mknudsen404-QA/4KeyPOC/CODEX_MICRO_CONSOLE_DESIGN.md

# Switchboard Design Decisions

Last updated: 2026-09-06

## Product Name

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

## Current Working Baseline

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

What is already working:

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

Current board port used during bring-up:

```text
/dev/cu.usbmodem2301
```

## Current Bridge Boundary

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

## Status Auto-Detection Plan

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

**Superseded first attempt (log-tail pattern matching).** The original plan was to tee session output via `script -q` and pattern-match the ANSI-stripped tail. Implemented and tested live, but a real captured log showed the flaw: Codex's TUI is a full-screen, cursor-positioned alternate-screen interface (`\e[row;colH` redraws, box-drawing glyphs), not linear scrolling text — naive ANSI-stripping cannot turn that into reliably matchable text; a correct version would need a real terminal emulator (`pyte`) to reconstruct the rendered screen first. The tee/log infrastructure (`host/logs/slot-N.log`, `poll_slot_logs`, `classify_activity`) is still in place as a secondary/best-effort signal, but is not the primary mechanism.

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

Known limitations: hooks only take effect for sessions started *after* `install-hooks` runs (already-running sessions, e.g. one launched before this was wired in, won't call the new hooks until restarted). The event→status mapping is a reasonable first guess, not yet calibrated against a full real session — `PreToolUse` only fires for `AskUserQuestion` specifically (not all tool calls), and Codex has no dedicated error/`blocked` hook signal (OpenMicro notes the same gap: "⚠️ Notification-text matching" for Claude, "— No error hook signal" for Codex), so `blocked` still depends on the secondary log-based classifier for now.

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

## Verified Hardware Facts

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

Rotary encoder guidance now that real pins are known:

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

## Project And Reference Locations

Primary live firmware project:

```text
/Users/matthewknudsen/Documents/Codex-Micro-Matt/Codex_Micro_Display
```

Design decisions:

```text
/Users/matthewknudsen/Documents/Codex-Micro-Matt/Codex_Micro_Display/CODEX_MICRO_CONSOLE_DESIGN.md
```

Session deliverable copies:

```text
/Users/matthewknudsen/Documents/Codex/2026-09-05/referenced-chatgpt-conversation-this-is-an/outputs/CODEX_MICRO_CONSOLE_DESIGN.md
/Users/matthewknudsen/Documents/Codex/2026-09-05/referenced-chatgpt-conversation-this-is-an/outputs/README_CODEX_MICRO.md
```

Stable copied PDF references:

```text
/Users/matthewknudsen/Documents/Codex-Micro-Matt/Codex_Micro_Display/docs/reference/5. LVGL Development Tutorial.pdf
/Users/matthewknudsen/Documents/Codex-Micro-Matt/Codex_Micro_Display/docs/reference/6. ESP32-S3 Development Board Diagram_V1.1.pdf
```

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

Original extracted Hiwonder source-code examples:

```text
/Users/matthewknudsen/Documents/Codex-Micro-Matt/Source Code
```

Key source-code examples:

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

Original Arduino examples:

```text
/Users/matthewknudsen/Documents/Codex-Micro-Matt/Arduino Program
```

Key Arduino examples:

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

Original archives:

```text
/Users/matthewknudsen/Documents/Codex-Micro-Matt/Arduino Program.rar
/Users/matthewknudsen/Documents/Codex-Micro-Matt/Source Code.rar
```

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

Claude review notes:

```text
/Users/matthewknudsen/Documents/Codex-Micro-Matt/Codex_Micro_Display/CLAUDE_REVIEW_BRIEF.md
/Users/matthewknudsen/Documents/Codex-Micro-Matt/Codex_Micro_Display/CLAUDE_FEEDBACK.md
```

Host bridge:

```text
/Users/matthewknudsen/Documents/Codex-Micro-Matt/Codex_Micro_Display/host/switchboard_bridge.py
/Users/matthewknudsen/Documents/Codex-Micro-Matt/Codex_Micro_Display/host/install_bridge_launch_agent.py
/Users/matthewknudsen/Documents/Codex-Micro-Matt/Codex_Micro_Display/host/README_BRIDGE.md
/Users/matthewknudsen/Documents/Codex-Micro-Matt/Codex_Micro_Display/host/EXTERNAL_KEY_SPIKE.md
/Users/matthewknudsen/Documents/Codex-Micro-Matt/Codex_Micro_Display/host/agents.example.json
```

## Core Concept

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

The screen answers three questions at a glance:

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

The controls send deliberate command intents:

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

## Layer Model

The first real layer set should be:

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

The current firmware still shows the older placeholder layers:

```text
CODEX
QA
SYSTEM
```

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

## Rotary Dial

The rotary dial should adjust the selected agent's reasoning effort.

Initial reasoning-effort scale:

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

## Visual Identity

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

Initial 8-bit identity sprites:

```text
CODEX
..####..
.#....#.
.#.##.#.
.#....#.
.#.##.#.
.#....#.
..####..
...##...

CLAUDE
..####..
.#....#.
.#.##.#.
.#....#.
.#.####.
.#....#.
..####..
..#..#..
```

Initial effort sprites:

```text
LOW
...##...
..#..#..
..#..#..
...##...
........
....#...
........
........

MEDIUM
...##...
..#..#..
..#..#..
...##...
........
...###..
.....#..
........

HIGH
...##...
..#..#..
..#..#..
...##...
........
..#####.
.....#..
..###...

XHIGH
...##...
..#..#..
..#..#..
...##...
..#..#..
...##...
..####..
.#....#.

MAX
..#..#..
...##...
.######.
#..##..#
...##...
..####..
.#.##.#.
#..##..#
```

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

Possible effort-color mapping:

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

Claude/Codex distinction:

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

## Illuminated Keys And Status

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

Target agent bank for v1:

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

Target command bank for v1:

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

Status should be key-light-first for glanceability and text-confirmed on screen:

```text
WORKING      + orange pulse
NEEDS INPUT  + yellow fast flash
BLOCKED      + red solid
DONE         + green or blue solid
```

Proposed lit-key meanings:

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

Status light behavior:

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

Hardware direction:

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

## Microphone Key

There should be a dedicated microphone key.

Decision: KEY4 becomes the microphone key on the Agents layer.

Behavior:

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

## Agent Navigation

The console should support four running CLI agents at once for v1.

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

The selected agent card should show:

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

Agent slot behavior:

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

Future rotary behavior:

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

## Agent Status Colors

The screen, illuminated keys, and future WS2812 LEDs should use the same status language.

| Status | Color | Meaning |
| --- | --- | --- |
| Empty | Off | No agent assigned to this slot |
| Idle | Dim white | Agent is available or task is quiet |
| Thinking | Purple pulse | Agent is reasoning or planning |
| Working | Orange pulse | Agent is actively doing work |
| Editing | Blue pulse | Agent is changing files |
| Testing | Amber or orange pulse | Agent is running checks |
| Waiting | Cyan slow pulse | Agent is waiting on tools, build, or external state |
| Needs Input | Yellow fast flash | User decision or clarification required |
| Blocked | Red solid | Agent cannot proceed without intervention |
| Done | Green or blue solid | Task completed or command succeeded |

Decision: illuminated keys are status indicators first. The screen should always keep the text status visible so color is never the only source of meaning.

Open color choice: Matthew likes orange for "working." Claude flagged that orange versus amber and red flash versus red solid may be hard to distinguish on real key hardware. Tentative revision: use yellow fast flash for Needs Input, red solid for Blocked, orange pulse for Working, and decide whether Testing deserves amber only after seeing real LEDs under real keycaps. Done can be steady green or steady blue; choose after seeing which color reads best on the actual key hardware.

## Command Keys

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

Bring-up mapping while only onboard KEY1-KEY4 are connected:

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

## Custom Slash Command

KEY4 on the Commands layer should trigger a configurable slash command.

Initial placeholder:

```text
/review
```

Better future behavior:

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

## Host Bridge

The ESP32-S3 firmware should stay focused on UI, inputs, status display, and audio capture.

Decision: a host-side bridge on the Mac should translate device events into Codex actions.

Suggested event names:

```text
agent.select
agent.focus
agent.reasoning.preview
agent.reasoning.apply
voice.toggle
voice.hold.start
voice.hold.stop
plan.approve
review.request
slash.run
system.status
```

Likely transport options:

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

Example event:

```json
{"event":"agent.reasoning.apply","agent":"current","effort":"high"}
```

Agent selection event:

```json
{"event":"agent.select","slot":3}
```

Agent focus event:

```json
{"event":"agent.focus","slot":3}
```

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

## Screen Layout Direction

The next screen should move from static layer text to a compact agent console.

Proposed Agents layer:

```text
CODEX MICRO CONSOLE

AGENT  3/4        HIGH

review-api-fix
WORKING
main/APP/lv_mainstart.c

KEY 3: ORANGE PULSE
ROTARY EFFORT
C3 APPLY  C4 HOLD MIC
```

Proposed Commands layer:

```text
COMMANDS

Approve Plan
Request Review
Run /review

C1 HOLD APPROVE
C2 REVIEW
C3 HOLD RUN
C4 HOLD MIC
C5 /SLASH
C6 BACK
```

## Near-Term Firmware Plan

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

## Hardware Direction Change: Bare Devkit + Detached Display

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

## Proof-of-Concept Hardware — Locked

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

Default 6-command mapping (customizable — see below):

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

## V2 Direction: Custom Single PCB

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

## Open Questions

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
