mknudsen404-QA/4KeyPOC/docs/design/hardening-pass-plan.md

# Hardening pass — second unit prep

Written 2026-10-03. Handoff document for an implementing agent. Scope set
by the owner in planning conversation: macOS-only install polish (not the
full cross-platform `auto-install-plan.md`), Codex voice fixed now with
Antigravity scoped as a research spike, log rotation closed for real, the
settings UI made discoverable without a terminal, and the 4key board
pushed to fab-ready.

This supersedes nothing — `auto-install-plan.md`, `family-capability-matrix.md`,
and `hardware/kicad/README.md` remain the source of truth for the larger
plans this pulls from. This document is the near-term slice actually being
built now, ahead of shipping a second unit.

## Workstream A — Voice: Codex now, Antigravity scoped

**Status (2026-10-03): A1 done, A2 done and went further than scoped —
confirmed live, not just spiked.** See `docs/design/family-capability-matrix.md`
for the full writeup. Summary:

- A1: Codex voice confirmed working end-to-end (macOS Dictation bound to
  F13, held via the board's PTT key, transcribed into a real Codex
  session). Two real bugs fixed along the way: `doctor.py` imported
  `AXIsProcessTrusted` from the wrong module (always reported
  Accessibility as ungranted even when it wasn't), and the Dictation
  availability check used a macOS preference key that no longer exists on
  macOS 26.
- A2: went from "research spike" to "shipped" in the same session —
  Antigravity CLI (`agy`, via `brew install --cask antigravity-cli`) now
  has a real `AntigravityProfile`, registered in the family registry,
  with effort control (clamped to what its default Gemini model actually
  supports) and voice PTT confirmed live the same way as Codex. Hooks are
  explicitly NOT wired (a real, scoped gap — Antigravity's hook mechanism
  is structurally different: project-local config file, synchronous
  execution that blocks the agent loop, a required JSON response contract
  per event, no session-start/session-end signal at all) — tracked in
  `families/antigravity.py`'s docstring for whoever picks it up next.
- A structural bug in the voice-PTT plumbing itself was found and fixed
  while verifying both of the above: the single shared `key_injector`
  posts events to one specific process (`CGEventPostToPid`) — correct for
  `claude_native` typing into Claude's own terminal, but silently
  incapable of triggering a system-wide OS shortcut like a configured
  Dictation hotkey (`CGEventPostToPid` bypasses global-hotkey dispatch
  entirely). `VoiceContext` now carries a second injector,
  `global_key_injector`, posting via `CGEventPost(kCGHIDEventTap, ...)`.
  This is what actually made the Codex and Antigravity verifications
  above possible, not just the chord/availability fixes.

**A1. Make Codex voice actually work (same-session fix, not a design problem).**
Per `family-capability-matrix.md`'s Phase 4 update, the `hotkey` provider is
wired and correct but has nothing to drive — no dictation app is installed
on this Mac, and built-in macOS Dictation has never been enabled
(`defaults read -g AppleDictationAutoEnable` returns "does not exist").

1. Enable built-in macOS Dictation (System Settings → Keyboard → Dictation)
   as the zero-install path — no new app, no license. Confirm its default
   shortcut doesn't collide with anything Switchboard already uses, and
   point `hotkey`'s `chord` at whatever that shortcut is (`switchboard/voice/hotkey.py`'s
   docstring names the exact check to redo).
2. Re-run Phase 4.4's validation: a Codex slot with `provider: hotkey`
   actually recording and landing transcribed text in the Codex prompt on
   a hold.
3. Update `doctor` / `/api/voice-providers` output and
   `family-capability-matrix.md` with the confirmed-live result — these
   already report availability honestly, they just need the underlying
   fact to flip from false to true.
4. If built-in Dictation proves unreliable (accuracy, latency, or requires
   per-hold network round-trip to Apple's servers in a way that feels
   bad), fall back to evaluating one real third-party app (Superwhisper is
   the most relevant price/quality point) as a second supported option —
   `hotkey` already doesn't care which app owns the shortcut.

**A2. Antigravity family-profile spike (research, not yet implementation).**
No `FamilyProfile` exists for Antigravity today — `grep` confirms zero
references anywhere in `host/switchboard/`. Follow the exact method
`family-capability-matrix.md` used for Gemini/Kimi: read Antigravity's own
docs/`--help`, install it for real if a CLI/terminal surface exists, and
fill in the same matrix row before writing code:

- Does it expose a CLI/terminal mode at all, or is it IDE-only (it's a
  VS Code-family agentic IDE — confirm whether any part of its agent loop
  is scriptable from a terminal session Switchboard could launch/observe).
- Lifecycle hooks: do any exist, what events, what config file/shape,
  does `SWITCHBOARD_SLOT` env passthrough survive.
- Effort/reasoning control: flag, config file, or none.
- Native voice/dictation surface, if any.
- Session-end signal.

Output: a new row in `family-capability-matrix.md`, same rigor as
Gemini/Kimi (mark anything unverified as unverified — don't guess).
**Do not write an `AntigravityProfile` until that spike has real answers**;
if it turns out IDE-only with no terminal/hook surface, the honest
`capabilities()` result may just be `tier="launch_only"` forever, same as
`GenericProfile` — which is a legitimate outcome, not a gap to fix.

## Workstream B — macOS install hardening (no MSC drive, no Windows)

**Status (2026-10-03): 1 done, 2 smoke-tested live (not a full matrix), 3
confirmed already adequate, 4 confirmed already structurally safe.**

- **1 — done.** `doctor` already exits non-zero only on a genuine `[fail]`
  (board-unplugged states were already `[warn]`, confirmed by reading
  every check in `doctor.py` — no separate `--strict` flag was needed).
  The actual gap was that `setup.sh` never called it at all; it now runs
  `doctor` as its final step and `die`s with a clear message if anything
  comes back `[fail]`. Found and fixed a real race surfaced by this: right
  after `install_bridge_launch_agent.py` restarts the bridge, the hook
  server needs a moment to bind its socket — `doctor` run immediately
  after could catch it mid-startup and print a spurious `[warn] hook
  port: nothing listening` on an install that was actually fine. Fixed
  with a bounded poll (up to 5s, moves on the instant the port answers)
  rather than a blind sleep.
- **2 — smoke-tested live on the real dev machine, twice in a row**
  (already fully set up: venv/agents.json/hooks/LaunchAgent all present).
  Both runs correctly skipped what existed, reported hooks "unchanged,"
  and the new `doctor` gate passed clean on the second run (after the
  race fix). This confirms the already-set-up case is genuinely
  idempotent; it is **not** the synthetic half-state test matrix the plan
  originally asked for (hooks-but-no-LaunchAgent, LaunchAgent-but-no-venv,
  etc.) — that would need a sandboxed `$HOME` harness and is still real,
  open follow-up work, not attempted this pass.
- **3 — already adequate, no change needed.** `doctor`'s `LaunchAgent`
  check already covers load state live (confirmed: it shells out to
  `launchctl print` and reports `[warn]` if not loaded) — `switchboard
  doctor` already is the "is it healthy right now" command the plan asked
  for; nothing to add.
- **4 — already structurally safe, documented rather than changed.**
  `install_bridge_launch_agent.py` always writes to the same fixed path
  (`~/Library/LaunchAgents/com.switchboard.bridge.plist`) under the same
  fixed label (`com.switchboard.bridge`), computed fresh from `__file__`
  at run time — launchd only ever tracks one job per label, so re-running
  `setup.sh` from a different checkout path correctly overwrites and
  reloads the single existing entry rather than creating a second one.
  Confirmed no legacy/differently-labeled plist exists on this machine
  today. The one scenario this doesn't cover — a bridge started by hand
  outside the LaunchAgent, left running, fighting over the serial port —
  is already *detected* by `doctor`'s serial-port check ("another bridge
  is running... busy"); actually *preventing* that (a pidfile/lock before
  `listen` binds the port) would be new mechanism for a rare, already-visible
  case, and wasn't built this pass.

Goal: `setup.sh` / the LaunchAgent survive re-runs, upgrades, and a
half-broken prior state without the user ever opening a terminal twice.
Reuses ideas from `auto-install-plan.md` Phase 2 (steps-as-objects,
`doctor --strict` as the consistency gate) without its cross-platform
`platform/` adapter layer, `uv` bootstrap, or MSC volume.

1. **`doctor --strict`**: add the exit-nonzero-on-any-fail variant called
   out in the original plan (today `doctor` reports but `setup.sh` doesn't
   gate on it). `setup.sh` runs it as the last step and tells the user
   exactly what failed instead of silently finishing "successfully" with a
   broken bridge.
2. **Idempotent re-run audit**: `setup.sh` already claims idempotency —
   verify it against a simulated half-state (venv exists but hooks don't;
   `agents.json` exists but LaunchAgent doesn't; old LaunchAgent present
   from a previous checkout path) rather than only the clean-machine case.
   Add this as a real test matrix, not just a doc claim.
3. **Self-healing LaunchAgent**: `KeepAlive: True` already restarts the
   bridge on crash. Add a `doctor`-driven health check path: a documented
   way to ask "is the installed bridge actually healthy right now" without
   re-running the whole installer (`switchboard doctor` already mostly
   does this — make sure it covers LaunchAgent load state, which it's
   listed as covering in `README_BRIDGE.md` but should be double-checked
   live).
4. **Migration safety**: if a second unit gets built on a Mac that already
   has an older checkout/LaunchAgent from this project's own dev history,
   re-running `setup.sh` must detect and cleanly replace it, never run two
   bridges fighting over the same serial port. This is explicitly called
   out as a risk in `auto-install-plan.md` 5.3 — worth covering even in
   the macOS-only slice since it's cheap and real (you, specifically, will
   hit this on your own machines).
5. **What's explicitly out of scope for this pass**: the `SWITCHBD` USB
   MSC drive, the signed/notarized installer, Windows support entirely.
   Those stay in `auto-install-plan.md` for when a GUI-only user is
   actually in the loop (e.g. shipping to someone who isn't you).

## Workstream C — Close the unbounded-log gap for real

**Status (2026-10-03): done, exactly as scoped, verified live.** Both
bugs fixed: `bridge.err.log` now rotates (it never did before), and
rotation is continuous, not just at process start — `RotatingStream`
(`host/switchboard/trace.py`) reassigns `sys.stdout`/`sys.stderr` to
instances backed by `logging.handlers.RotatingFileHandler` (same
mechanism `TraceWriter` already used for `trace.jsonl`), active only
under the LaunchAgent (`SWITCHBOARD_MANAGED_LOGS=1`, set in the plist) so
an interactive terminal run is unaffected. `install_bridge_launch_agent.py`
keeps launchd's own `StandardOutPath`/`StandardErrorPath` as a
crash-visibility fallback for the brief window before reassignment runs.
Verified live: regenerated the plist, restarted the LaunchAgent, confirmed
fresh timestamped lines land in `bridge.out.log` through the new path and
`doctor` stays green. Audited for other unbounded writes
(`grep -rn "open(.*['\"]a['\"]"`) — none found; `agent_registry.json` is
rewritten whole, not appended, so it was never a log in the first place.

Two concrete bugs found, not a redesign:

1. **`bridge.err.log` is never rotated at all.** `_rotate_bridge_out_log`
   (`host/switchboard/cli.py`) only ever touches `bridge.out.log`. Apply
   the identical rename-on-oversize treatment to `bridge.err.log` at the
   same call site.
2. **Rotation only happens at process start, not during a long-running
   session.** `_rotate_bridge_out_log()` is called once in `listen()`
   before the reconnect loop. The LaunchAgent (`KeepAlive: True`, `RunAtLoad:
   True`) is designed to stay up for weeks, so a healthy bridge that never
   crashes never rotates again after its first start. Worse: per the
   function's own docstring, renaming the path mid-run doesn't actually
   stop the *current* process's writes from landing in the renamed
   (still-open) inode — the rename only helps the *next* restart get a
   fresh file. True continuous bounding needs the bridge to stop relying
   on launchd's raw `StandardOutPath`/`StandardErrorPath` fd inheritance
   and instead manage its own output the way `trace.py` already manages
   `trace.jsonl` (a real `RotatingFileHandler`-backed stream that Python
   itself reopens on rotation). Concretely: redirect `sys.stdout`/`sys.stderr`
   in `listen()` to a small wrapper around `RotatingFileHandler` when
   running under the LaunchAgent (detect via an env var the plist sets),
   leaving interactive terminal runs untouched.
3. Add a regression test: a fake writer that pushes bytes past `max_bytes`
   across multiple simulated "ticks" (not just at start) and asserts the
   file never exceeds a bound, mirroring the existing
   `test_status_table_header_is_current`-style guard-rail tests.
4. Audit anything else that writes unboundedly: `agent_registry.json` is
   state, not a log (rewritten whole, not appended — fine). Hook curl
   calls (`curl -s --max-time 1 ... || true`) don't write locally. Confirm
   nothing else was missed with a quick `grep -rn "open(.*['\"]a['\"]" host/`.

## Workstream D — Make the settings UI findable without a terminal

**Status (2026-10-03): done, built differently than originally proposed
below — the owner asked for "an icon like every other application,
double-click it and it opens settings" rather than a persistent menu bar
status item, which is both simpler and needed no new dependency.**

What shipped: `switchboard/osa_app.py`, a small shared helper that builds
a plain double-clickable macOS `.app` via `osacompile` (built into macOS)
wrapping one shell command, with `try`/`on error` AppleScript so a
failure shows as a native notification (using the wrapped command's own
stderr as the message) instead of silently doing nothing. Two apps built
on it, both regenerated fresh by `setup.sh` on every run (paths are
baked in per-machine, same reasoning as the LaunchAgent plist):

- **`install_settings_app.py`** → `~/Applications/Switchboard Settings.app`
  — wraps the existing `switchboard settings` CLI command verbatim, so a
  double-click either opens the settings page or shows "No bridge is
  listening..." as a notification if it isn't running.
- **`install_update_app.py`** → `~/Applications/Switchboard Update.app`
  — `git pull --ff-only && setup.sh`, with a success notification
  ("Switchboard is up to date.") or the git/setup failure surfaced the
  same way. This was the owner's own follow-up ask mid-session ("we
  probably should have something very nice and simple for pushing
  updates") — intentionally the simplest thing that could work for the
  macOS-only, dev-checkout-based scope this whole pass is already
  working within (`--ff-only` refuses rather than guesses if the local
  checkout ever has commits of its own), not the full signed-release
  `switchboard upgrade` from `auto-install-plan.md`.

Both verified live end-to-end: double-clicked each, confirmed the
settings page opened and the update notification appeared; separately
verified the Settings app's failure path by stopping the bridge first
(see the incident note below).

Covered by `host/tests/test_osa_app.py` (the AppleScript-escaping logic
specifically — the one part worth real test coverage; the two top-level
install scripts stay untested like `install_bridge_launch_agent.py`
already was, consistent with this repo's existing convention for that
category of script).

**Incident note**: stopping the bridge to test the Settings app's
failure path (on the same slot actively being used for this session)
caused a real `Stop` hook to be silently dropped — the fire-and-forget
curl hook has no retry by design, so a slot's status can get stuck
showing busy if the bridge happens to be down for the instant a hook
fires. Not a new bug, just newly demonstrated; self-corrects on the next
status-changing event once the bridge is back. No change made — logged
here in case it's worth a retry/staleness fallback later.

**Not built, and deliberately not**: the menu bar `rumps` approach
originally proposed below, a full native app bundle project, a Dock
icon, or any code signing/notarization — none of it was needed once the
actual ask turned out to be simpler than the plan assumed.

<details>
<summary>Original proposal (superseded by the above)</summary>

Proposed fix: a small macOS **menu bar helper** (status item, not a Dock
app), the minimum-infra way to give this product a persistent "it's alive
and here's where to configure it" surface:

- New tiny companion script (`host/switchboard_menubar.py`), built on
  `rumps` (single new dependency, pure-Python, no Xcode project needed).
  Runs as its own LaunchAgent, separate from the bridge process — `rumps`
  needs the main thread for its `NSApplication` run loop, which doesn't
  mix cleanly with the bridge's own threads, and keeping it a separate
  process means a menu bar crash can never take the bridge down (and vice
  versa).
- Menu: current connection state (board plugged in? bridge running?
  pulled from the same loopback endpoint `doctor`/the settings page
  already use), "Open Settings", "Run Doctor" (shows `doctor`'s output in
  a simple window or notification), "Download Diagnostics" (same
  `support-bundle` the settings page already exposes), "View Logs".
- Icon reflects the single most useful glance-state: grey = bridge not
  running, color = running (optionally reusing the same status-color
  language already defined for the keys/screen, for visual consistency
  with the rest of the product).
- Installed by the same `setup.sh` pass as the bridge LaunchAgent — one
  install, two small long-running helpers, consistent with how the bridge
  itself is already installed.
- Explicitly not building: a full native app bundle, a Dock icon, or
  anything requiring code signing/notarization for this internal/gift-unit
  stage. `rumps` apps run fine unsigned for local/per-user use.

</details>

## Workstream E — 4key board: close the fab-blocking punch list

**Status (2026-10-03): the two biggest open questions resolved (safely),
three real generator bugs found and fixed, one real gap surfaced that still
needs a human decision.** Full detail lives in `hardware/kicad/README.md`'s
"ERC/DRC status" and "Symbols and footprints" sections now — this is the
summary.

Verified against primary-source datasheets (not search-engine summaries,
which were caught being wrong twice along the way — once claiming XL9555's
SDA/SCL were swapped, once claiming two ESP32-S3-WROOM-1 GND/thermal pins
were GPIOs): all 41 ESP32-S3-WROOM-1 pins and all 24 XL9555 pins in
`boarddef.py` match their real datasheets exactly. An independent Opus
review of the whole design, run in parallel, confirmed this and caught
three things a pinout check alone couldn't:

1. `gen_pcb.py` ignored `p.nc` entirely (`gen_sch.py` didn't) — real
   schematic/PCB drift, fixed.
2. No bulk cap at U1's own +3V3 pin — added (C9), routed, DRC-clean on all
   three tiers.
3. No USB ESD protection — added (a USBLC6-2SC6 TVS array, D_ESD), pinout
   confirmed against the actual symbol KiCad ships, left unrouted like the
   rest of the differential pair.

All three tiers regenerated and re-verified: 0 DRC violations, 0 ERC
violations (up from 34/38/42 unconnected items to 39/43/47 — expected,
from D_ESD's new unrouted nets, nothing previously-routed changed).

One real gap surfaced, not yet closed: the LED footprint/part pairing
(`boarddef.py` uses the plain SK6812MINI, not the "-E" variant) is
internally consistent, but the current-budget math upstream of this
workstream was computed against the wrong datasheet (the "-E" one) — the
plain part's own datasheet doesn't list a per-channel current figure the
same way. Needs the exact SKU locked down before ordering, not a code fix.
Also confirmed: no enclosure/case file exists in this repo at all (only a
version-badge tile), so the mounting-hole-vs-case punch list item is
currently impossible to do, not just undone. And the trademark gut-check
elevated "THE SWITCH" specifically as the one to worry about (same product
class as Nintendo's Switch mark) — treat all three tier nicknames as
internal codenames until a real search is done.

`hardware/kicad/4key/README.md`'s "Before you send these to a fab" list is
already the right checklist — this workstream is executing it, in the
order that front-loads the highest-cost-to-get-wrong items first (matches
the README's own ordering):

1. **Physical test-fit** — print the key field 1:1, test-fit a real Kailh
   hot-swap socket, a real Gateron MX switch (already have 36 on hand),
   and a real SK6812MINI. Confirms socket pads, 3.05 mm pin holes, 4 mm
   centre hole, ±5.08 mm plate holes, and the LED's 5.0 mm offset/side —
   called out as the one check that cannot be skipped.
2. **XL9555 footprint verification** — the schematic currently stands in
   `Interface_Expansion:PCF8575DBR` for the XL9555. Either confirm the
   TSSOP-24 pinout truly matches against the XL9555 datasheet, or simplify
   by just buying PCF8575s for v1 (functionally identical to the firmware,
   per the README) and dropping the open question entirely.
3. **ESP32-S3-WROOM-1 footprint + module variant** — verify pad
   pitch/thermal-pad/keepout against Espressif's datasheet; confirm N16R8
   specifically (octal PSRAM owns IO35/36/37, already reserved as
   no-connects here).
4. **I2C address collision check** — confirm 0x20 is free (it should be,
   this is a from-scratch board, not the old WonderLLM's shared bus) and
   decide now whether a second expander (for a future tier) needs A0 tied
   high for 0x21, even though 4key doesn't need it.
5. **Finish unrouted nets**: `KEY1-4` to expander I/O, the `USB_DP`/`USB_DM`
   differential pair, `CC1`/`CC2`, `~RESET`/`BOOT`, `EXP_INT` + pull-up,
   I2C pull-ups, `J2` header nets. Re-run `kicad-cli pcb drc` and
   `kicad-cli sch erc` after.
6. **LED supply budget** — confirm the actual SK6812MINI part's VDD
   range/current, size the 5 V trace widths and 22 µF bulk cap for 4 keys'
   worst-case draw (far under the 12-key tier's ~0.7 A headroom
   calculation, but still worth a real number for 4key specifically).
7. **USB-C shield-to-GND decision** — confirmed direct-to-GND in the
   generator; just make the explicit call and move on.
8. **Mounting holes vs. the real enclosure** — check the antenna-keepout-driven
   asymmetric hole pattern against the actual 3D-printed case file in
   `hardware/enclosure/`, not just the schematic.
9. **Trademark check** — "THE STICK" (4key's silkscreen nickname) in the
   relevant classes before it's on a product that leaves the house, per
   `docs/design/4key-business-plan.md`'s IP section. Confirm neither
   "Claude" nor "Codex" appear anywhere on silkscreen (README states they
   don't — verify).
10. **Order the stackup**: black soldermask / white silkscreen (already in
    the generated stackup) + ENIG, first batch sized for one working unit
    plus spares (most fabs have a 5-board minimum anyway) — confirm fab
    choice and quantity as an explicit decision before submitting.

Acceptance for this workstream: `4key/4key.kicad_pcb` passes DRC with zero
violations and zero *unintended* unrouted nets (the ratsnest items above
all closed), the open questions in the README's "what is real and what is
a stand-in" section are each resolved to a yes/no, and there's a one-line
decision record for quantity + fab house before the order is placed.

## Suggested order

A1 (Codex voice) and C (log rotation) are both same-day, low-risk fixes —
do them first, in parallel if working with subagents. B (install
hardening) and E (hardware punch list) are the two real bodies of work
this pass and don't depend on each other — run them in either order or
in parallel. D (menu bar) is small but benefits from B being done first
(nothing to surface in the menu bar until the install path it's
describing is trustworthy). A2 (Antigravity spike) is pure research and
can happen any time, independently.

## Open decisions for the owner

- A1: built-in Dictation vs. a named third-party app as the Codex
  default — proposed built-in first, fall back only if it's bad in
  practice.
- D: confirm `rumps` as an acceptable new dependency (pure Python, no
  signing needed) vs. a lighter-weight alternative (e.g. skip the menu
  bar and just have `setup.sh` auto-open the settings page once per
  login instead of a persistent icon).
- E: fab house and first-batch quantity (locked parts list already exists
  in `SWITCHBOARD_DESIGN.md`; this just needs a number).
