mknudsen404-QA/4KeyPOC/host/README_BRIDGE.md

# Switchboard Host Bridge

## Setting up on a new Mac

```sh
git clone https://github.com/mknudsen404-QA/4KeyPOC.git
cd 4KeyPOC/host
./setup.sh
```

`setup.sh` is idempotent — safe to re-run any time (e.g. after a fresh `git
pull`). It creates the venv, installs the voice-hold dependency, creates
`agents.json` from the template (agents launch in `~/Documents` by default —
see "Default working directory" below), installs the Claude Code/Codex
lifecycle hooks, and installs the bridge as a login LaunchAgent.
The first time you use push-to-talk on that Mac, grant the Accessibility
permission prompt, then restart the bridge (`launchctl unload` +
`launchctl load` the plist, or just re-run `setup.sh`) since a process
doesn't pick up a newly-granted permission without restarting.

This is the first Mac-side bridge for Switchboard.

It now has two jobs:

1. Launch/register Codex or Claude CLI sessions into three stable agent slots (a 4th key is dedicated push-to-talk).
2. Read JSON-lines events from the board, print what they mean, and push registered slot status back to the screen.

It is still observe-only for mutating actions: it does not approve plans, run slash commands, focus terminals, send text into agents, or start microphone recording yet. It also does not yet observe live Codex/Claude terminal output, so it cannot automatically know that a launched agent is asking for access or waiting for input.

The bridge must be running on the Mac for the hardware to control anything. The ESP32 board is only the controller; the Mac-side bridge is the driver/daemon that listens for button events and launches or controls agents.

## Architecture

`switchboard_bridge.py` is a small entry-point shim; the whole
implementation lives in `host/switchboard/`, split so the decision logic
(what should a status change *do*) has no dependency on any real serial
port, subprocess, or file:

```text
board (JSON lines)         CLI lifecycle hooks (HTTP POST)
        |                              |
        v                              v
  device.lines()                hooks_server.py
        |                              |
        +----------> Bridge.submit() <-+
                          |
                    (single queue)
                          |
                    Bridge.step()  <---- the only place that touches
                          |              the registry inside this process
              +-----------+-----------+
              |                       |
      registry.transaction()     reduce() (pure)
              |                       |
        registry.json           [Effect, Effect, ...]
                                      |
                    +-----------------+-----------------+
                    |         |          |         |
              SendUpdate   Launch      Focus    VoiceKey
                    |         |          |         |
              device.send  terminal   terminal   terminal
                          .open()+    .focus()   .post_key()
                          build_launch()
```

| module | job |
| --- | --- |
| `model.py` | effort mapping, record shapes — pure data, no clock/I-O; re-exports the status vocabulary from `status_table.py` |
| `status_table.py` | the status vocabulary: busy-ness, per-family hook mappings, LED color/pulse — generates `firmware/neokey/status_table.h` |
| `events.py` | `BoardEvent`/`HookEvent`/`LivenessObserved`/`SlotRegistered`/`Shutdown`, `parse_board_line` |
| `reducer.py` | `reduce(slots, state, event, now) -> (slots, effects)` — pure; every status-change rule lives here |
| `clock.py` | `Clock` protocol + `SystemClock`/`FakeClock` |
| `registry.py` | `Registry(path)` — load/save/transaction (the on-disk source of truth) |
| `device.py` | `DeviceLink` protocol — `SerialDevice`/`FdDevice`/`FileDevice`/`FakeDevice`, plus `sync_device` |
| `liveness.py` | `ProcessProber`/`FakeProber` — is the process behind a slot's terminal still running? |
| `terminal.py` | `TerminalDriver` protocol — `AppleScriptTerminal`/`NullTerminal`/`FakeTerminal` (the only file that touches `osascript`) |
| `launcher.py` | resolving a command/cwd/effort into a `LaunchPlan`, plus the `config` subcommand |
| `hooks_server.py` | the hook HTTP listener — turns a POST into a `HookEvent`, nothing else |
| `hooks_install.py` | registering hooks with Claude Code/Codex |
| `doctor.py` | the `doctor` subcommand — probes the real environment, doesn't guess |
| `bridge.py` | `Bridge` — owns the queue, the three producer threads, and `step()`/`startup_sync()` |
| `cli.py` | `build_parser()` + every subcommand function; `main()` |

## Adding a status

`host/switchboard/status_table.py`'s `STATUSES` table is the single source
of truth — busy-ness, which hooks (per CLI family) produce it, and its LED
color/pulse.

1. Add (or edit) a row in `STATUSES`.
2. Regenerate the firmware header:
   ```sh
   python3 -m switchboard.status_table --emit-header > firmware/neokey/status_table.h
   ```
3. Run `host/.venv/bin/python -m pytest host/tests -q` and
   `firmware/neokey/test/run.sh` — both must stay green.
   (`test_status_table_header_is_current` fails with the exact command
   above if you forget step 2.)

`STATUS_CHOICES`, `BUSY_STATUSES`, `CLAUDE_HOOK_STATUS`, `CODEX_HOOK_STATUS`,
and the hook-installer's matcher table all derive from this one table —
nothing else needs editing by hand.

## Voice hold (needs a venv)

`voice.hold.start`/`voice.hold.stop` drive whichever `switchboard/voice/`
provider a slot resolves to (`host/switchboard/settings.py`'s optional
per-slot `voice` field, defaulting to the slot's family — see
`FamilyProfile.default_voice()`): the bridge focuses the selected slot's
Terminal tab, then asks the provider to hold/release. Two providers are real
today —

- **`claude_native`** (Claude's own default): a true press-and-hold, a real
  synthetic spacebar keyDown on hold-start and keyUp on hold-stop, driving
  Claude Code's `/voice` hold-to-record mode. Confirmed working.
- **`hotkey`** (Codex's default, and every other/unknown family's): drives a
  system-wide dictation app's own shortcut instead, so it works regardless of
  which CLI is running — but it's **not verified on this machine**: no known
  dictation app is installed and macOS's built-in Dictation has never been
  enabled here (see `switchboard/voice/hotkey.py`'s docstring for the exact
  check). `doctor` and the settings UI's `/api/voice-providers` both report
  this honestly as unavailable rather than pretending it works. It's also
  currently limited to chords that map to a single bare keycode (just
  `"space"` today) — multi-key chords like `ctrl+space` need modifier
  support `key_injector.py`'s `KeyInjector` doesn't have yet.

A slot with no usable provider (`"none"`, or an unconfigured/unavailable one)
just logs that voice isn't set up for it — see `switchboard/voice/none.py`.

**You must turn on `/voice` yourself, once per session, before using the PTT
key.** The bridge does not do this for you. An earlier version tried to
auto-detect and auto-toggle `/voice` by tailing the terminal's log for its
"Voice mode enabled."/"disabled." message, but that's unreliable against
Claude Code's TUI (it does full-screen ANSI redraws, not scrolling text, so a
byte-tail search can miss the toggle message) — it ended up silently
flipping voice mode the wrong way, and once even landed a `/voice` keystroke
as a real chat message mid-render (a real, billed turn). Simpler and safer:
you own `/voice`'s on/off state by hand; the bridge only ever sends the
hold/release keypresses once it's on.

This needs `pyobjc-framework-Quartz`, which Homebrew's system Python won't let
you `pip install` directly (PEP 668). Use the project-local venv instead:

```sh
cd host
python3 -m venv .venv
./.venv/bin/pip install pyobjc-framework-Quartz pyobjc-framework-ApplicationServices
./.venv/bin/python3 switchboard_bridge.py listen --port /dev/cu.usbmodem2301 --auto-launch
```

Running the bridge with plain `python3` still works for everything else
(select/launch/status/sync) — voice hold just no-ops with a clear error
message ("Quartz is not installed...") until you run it with the venv's
Python instead.

The very first time you use voice hold, macOS will prompt for **Accessibility**
permission for whatever process is running the bridge (Terminal, or the venv's
python3) — this is required for `CGEventPostToPid` to work. Grant it once in
System Settings -> Privacy & Security -> Accessibility.

## Run with the board

From the firmware project folder:

```sh
python3 host/switchboard_bridge.py
```

If the board is on a known port:

```sh
python3 host/switchboard_bridge.py --port /dev/cu.usbmodem2301
```

The explicit subcommand is:

```sh
python3 host/switchboard_bridge.py listen --port /dev/cu.usbmodem2301
```

Auto-launch empty agent slots when their button event arrives:

```sh
python3 host/switchboard_bridge.py listen \
  --port /dev/cu.usbmodem2301 \
  --auto-launch
```

For development, register slots without opening Terminal windows:

```sh
python3 host/switchboard_bridge.py listen \
  --port /dev/cu.usbmodem2301 \
  --auto-launch \
  --no-open
```

Close a slot's Terminal tab too, not just free the slot, when its process
is confirmed dead (default: off — the tab is left alone so its
"[Process completed]" scrollback stays visible):

```sh
python3 host/switchboard_bridge.py listen \
  --port /dev/cu.usbmodem2301 \
  --auto-launch \
  --close-dead-tabs
```

This never applies to `/exit` (SessionEnd) — the user asked for that
shell to stay, and it does.

## Test without the board

```sh
python3 host/switchboard_bridge.py --sample
```

## Launch one agent slot

This registers Agent 1 and opens a new macOS Terminal window running Codex.
Agents launch in `~/Documents` by default (`--cwd` overrides it for one slot,
or use `switchboard_bridge.py config --default-cwd PATH` for all of them):

```sh
python3 host/switchboard_bridge.py launch \
  --slot 1 \
  --name Maestro \
  --family codex \
  --command codex
```

Preview without opening Terminal:

```sh
python3 host/switchboard_bridge.py launch \
  --slot 1 \
  --name Maestro \
  --command codex \
  --dry-run
```

Register without opening Terminal:

```sh
python3 host/switchboard_bridge.py launch \
  --slot 1 \
  --name Maestro \
  --command codex \
  --no-open
```

## Which CLI each agent key launches

Auto-launch and `launch-all` both read `host/agents.json` if it exists, falling
back to the checked-in `host/agents.example.json` template otherwise.
`agents.json` is yours — not checked in, safe to edit freely (or edit it with
`switchboard_bridge.py config`, see below). It's a settings v2 document
(`"settings_version": 2`, `"slots"` — see `host/switchboard/settings.py`);
an older v1 file (`"agents"` instead of `"slots"`) still loads fine and is
migrated in memory the first time you run `config`, written back only once
you actually change something. Each slot is:

```json
{ "slot": 1, "name": "Maestro", "family": "codex", "command": "codex", "args": [], "cwd": "...", "effort": "medium" }
```

Change `family` (`codex` or `claude`) and `command` per slot to control the
codex/claude mix — nothing stops all three slots from being the same family, or
all different. `effort` is optional (defaults to `medium`) and sets the
starting reasoning effort for that slot's session. `cwd` resolves in this
order: the slot's own `cwd` -> the top-level `"defaults": {"cwd": "..."}` ->
`~/Documents`. A missing `cwd` under `~/Documents` is created automatically;
anywhere else, launching fails with a hint to fix it via `config`.

Edit a slot (or the shared default) without hand-editing JSON:

```sh
python3 host/switchboard_bridge.py config --slot 1 --name Maestro --family codex --command codex --cwd ~/Documents/my-project
python3 host/switchboard_bridge.py config --default-cwd ~/Documents
python3 host/switchboard_bridge.py config --show
```

Changes take effect on that slot's next launch, not any session already running.

## Launch the three-slot example

The example config is `host/agents.example.json` — copy it to `host/agents.json`
to make it your own editable copy (already done once; see above).

```sh
python3 host/switchboard_bridge.py launch-all
```

The current example maps:

| Slot | Name | CLI |
| --- | --- | --- |
| 1 | Maestro | codex |
| 2 | Scout | codex |
| 3 | Claude | claude |

Key 4 is push-to-talk, not an agent slot — see "Voice hold" below.

Preview the full launch set:

```sh
python3 host/switchboard_bridge.py launch-all --dry-run
```

List registered slots:

```sh
python3 host/switchboard_bridge.py slots
```

## Settings web UI

The easiest way in: double-click `~/Applications/Switchboard Settings.app`
(installed by `setup.sh`) — a plain macOS app, no terminal needed. If the
bridge isn't running it shows a notification saying so instead of opening
a dead page.

While the bridge (`listen`) is running, `switchboard settings` opens the
same small loopback-only web page for editing the same three slots
`config` edits — no JSON, no terminal:

```sh
python3 host/switchboard_bridge.py settings
```

It checks that a bridge is actually listening first, prints the page's URL,
and opens it in the default browser (`--no-browser` to just print the URL,
useful over SSH). The page is served by the bridge itself on
`127.0.0.1:8877`; it only exists while a bridge is running, so `settings`
prints "start the bridge first" instead of opening a dead tab if there isn't
one. A per-run token (embedded in the page, required on the save request)
plus a Host/Origin check block DNS-rebinding and cross-site requests from
any other page open in the same browser — there's no login beyond that,
since it's your own machine and your own process.

Save is whole-document with optimistic concurrency: if `config` (or another
browser tab) changed the file since the page loaded it, Save reloads the
latest version instead of clobbering it. Changes apply on each slot's next
launch, same as `config`.

## Real status auto-detection (lifecycle hooks)

Run once to wire Switchboard into Claude Code's and Codex's real lifecycle hooks
(`SessionStart`, `UserPromptSubmit`, `Stop`, etc.) so status updates on its own
instead of only ever being set by hand:

```sh
python3 host/switchboard_bridge.py install-hooks
```

Safe to re-run any time (idempotent, merges into your existing
`~/.claude/settings.json` / `$CODEX_HOME/hooks.json` without touching unrelated
settings). Takes effect for sessions launched *after* this runs — an
already-open Terminal window won't pick up new hooks until restarted. See
"Status Auto-Detection Plan" in `SWITCHBOARD_DESIGN.md` for how it works
and its known gaps (credit to [OpenMicro](https://github.com/stephenleo/OpenMicro)
for validating this approach).

Codex specifically gates each configured hook command on a persisted
"trust" hash (`[hooks.state]` in `~/.codex/config.toml`) — the first real
interactive Codex session after `install-hooks` establishes that trust
automatically; nothing else to do by hand. Confirmed live: `codex exec`
(non-interactive) silently skips *untrusted* hooks with no error at all,
which looks identical to "hooks just don't fire" unless you know to check
`config.toml`'s `[hooks.state]` table or pass
`--dangerously-bypass-hook-trust`.

## Doctor

`doctor` probes the bridge's actual operating environment — nothing here
is guessed from config — and prints one `[ok]`/`[warn]`/`[fail] name:
detail` line per check: the serial port, the hook HTTP listener, whether
Claude Code/Codex hooks are installed and current, Terminal automation
permission, Accessibility permission (needed for voice PTT), every
registered slot's actual liveness, whether `agents.json`'s working
directories exist or are creatable, and whether the LaunchAgent is loaded.

```sh
python3 host/switchboard_bridge.py doctor
```

Exits 1 if any check is `[fail]`. `--json` emits the same checks as a JSON
array (`[{"name", "level", "detail"}, ...]`) instead of text lines, for
scripting. `--port`, `--registry`, and `--agents-config` override what it
probes, same as `listen`/`launch`.

## Diagnostics

Every `listen` run writes a second log alongside `bridge.out.log`:
`~/Library/Logs/Switchboard/trace.jsonl` — one JSON object per line, one
line per event the bridge processes (a hook, a board event, a liveness
probe, a status transition, a 60-second heartbeat per slot). It's the
input for questions `bridge.out.log` alone can't answer, like "how long
was this slot stuck in `needs_input`" or "did the board free this slot
because the CLI actually exited, or because a liveness probe glitched":

```sh
jq -c 'select(.kind=="transition")' ~/Library/Logs/Switchboard/trace.jsonl
```

It's redacted by default: hook payloads are reduced to a session hash,
the notification type, the tool name, and the agent id — never prompt
text, tool input/output, or file paths. That's what makes it safe to zip
up and hand over without reading it first (see `support-bundle` below).
Pass `--trace-verbose` (or set `SWITCHBOARD_TRACE_VERBOSE=1`, for the
LaunchAgent case) to keep full hook payloads instead, for a session
where you're actively reproducing something on your own machine.

`trace.jsonl`, `bridge.out.log`, and `bridge.err.log` are all
size-bounded (rotated continuously at 5&nbsp;MB, 2 backups kept) — under
the LaunchAgent, the bridge owns its own stdout/stderr (reassigned at
startup, `SWITCHBOARD_MANAGED_LOGS=1` in the plist) rather than relying
on launchd's raw fd redirection, specifically so a `KeepAlive` process
that stays up for weeks still rotates mid-run, not only across restarts.
An interactive `listen` run in a terminal is unaffected and keeps
printing normally. `bridge.out.log`'s own noisiest lines (`No USB serial
port found`, printed once per retry while the board is unplugged) are
also collapsed to a first occurrence plus an occasional marker instead
of one line per tick, which was 179,386 of 179,734 lines in a one-week
capture before this existed.

To hand a bug to someone else (or to us), zip everything up:

```sh
python3 host/switchboard_bridge.py support-bundle
```

Prints the path to a zip on your Desktop containing `trace.jsonl`, a tail
of `bridge.out.log`/`bridge.err.log`, `doctor`'s checks, `agents.json`,
the agent registry, version info, the LaunchAgent plist, and only the
Switchboard-owned entries from your Claude/Codex hook config files (never
the whole file). It works with no bridge running and no board connected
— that's exactly when you're most likely to need it. `--since 2h` trims
the trace to a recent window; `--out PATH` picks the destination;
`--include-payloads` keeps verbose-mode payload fields if the trace was
recorded with `--trace-verbose` (off by default, with a warning printed
if anything was stripped). The same bundle is one click away from the
settings page (`switchboard settings`) as "Download diagnostics", gated
by the same per-run token as everything else on that page.

## Track status

The bridge registry now stores status, effort, and activity per slot.

Mark Agent 2 as working:

```sh
python3 host/switchboard_bridge.py status \
  --slot 2 \
  --status working \
  --activity "running tests"
```

Mark Agent 2 done:

```sh
python3 host/switchboard_bridge.py status --slot 2 --status done
```

Clear Agent 2:

```sh
python3 host/switchboard_bridge.py clear --slot 2
```

Push registered status back to the board:

```sh
python3 host/switchboard_bridge.py sync --port /dev/cu.usbmodem2301
```

Push one slot and wait for the board to confirm the update:

```sh
python3 host/switchboard_bridge.py sync --port /dev/cu.usbmodem2301 --slot 1
```

The shorter form also works:

```sh
python3 host/switchboard_bridge.py sync --port /dev/cu.usbmodem2301 1
```

A healthy round trip prints:

```text
Sent Agent 1 status to board
Board applied update for Agent 1
```

While the bridge is running (`listen`), every `agent.update` it sends is
tracked until acked. If the board hasn't acked one within a second, the
liveness ticker resends it — up to 3 attempts total — then gives up and
logs `slot N: board did not ack after 3 attempts` rather than retrying
forever.

Current statuses:

```text
empty
launched
idle
thinking
working
waiting
needs_input
blocked
done
```

## External key switch spike

The current firmware has one direct external switch input enabled:

```text
GPIO44 (RXD0) ---- switch ---- GND
```

GPIO44 acts as External Agent Key 1. It is separate from the onboard KEY1-KEY4 buttons.

See `host/EXTERNAL_KEY_SPIKE.md`.

## Install as a login background bridge

For a real user-facing setup, install the bridge as a macOS LaunchAgent. That makes it start at login and keep waiting for the board if the board is not plugged in yet.

Preview the install:

```sh
python3 host/install_bridge_launch_agent.py --dry-run
```

Install and start it:

```sh
python3 host/install_bridge_launch_agent.py
```

Development install that does not open Terminal windows:

```sh
python3 host/install_bridge_launch_agent.py --no-open
```

Also close a slot's Terminal tab when its process is confirmed dead
(default off, same as `listen --close-dead-tabs`):

```sh
python3 host/install_bridge_launch_agent.py --close-dead-tabs
```

The LaunchAgent writes:

```text
~/Library/LaunchAgents/com.switchboard.bridge.plist
~/Library/Logs/Switchboard/bridge.out.log
~/Library/Logs/Switchboard/bridge.err.log
```

The installed bridge runs with `--auto-launch --retry`. It waits for the board, then launches/registers an empty agent slot when an agent button event arrives.

## Updating

Double-click `~/Applications/Switchboard Update.app` (installed by
`setup.sh`): it runs `git pull --ff-only` in this checkout, then re-runs
`setup.sh` so any new hooks/dependencies/LaunchAgent changes apply, and
shows a notification either way ("Switchboard is up to date." on
success, or the git/setup error if something went wrong — e.g. a
non-fast-forward pull because the checkout has local commits of its
own). The same thing by hand:

```sh
git pull --ff-only && host/setup.sh
```

## CLI discovery

The bridge resolves `codex` and `claude` in this order:

1. The current PATH.
2. Known local app/binary locations.
3. An absolute path passed through `--command`.

On Matthew's Mac, Codex resolves to:

```text
/Applications/ChatGPT.app/Contents/Resources/codex
```

Claude resolves to:

```text
/Users/matthewknudsen/.local/bin/claude
```

## Current firmware events

Board -> bridge:

```json
{"event":"agent.select","slot":1}
{"event":"agent.focus","slot":1}
{"event":"agent.reasoning.apply","slot":1,"effort":"HIGH"}
{"event":"voice.hold.start","slot":1}
{"event":"voice.hold.stop","slot":1}
{"event":"agent.update.ack","slot":1}
{"event":"boot","stage":"start","firmware":"neokey","build":"Sep 14 2026 12:00:00"}
{"event":"error","reason":"seesaw_no_response","attempt":1}
{"event":"boot","stage":"ready","firmware":"neokey","attempts":0}
```

`boot`/`stage":"start"` is sent right after `Serial.begin()`, before the
seesaw is touched. If the seesaw doesn't answer, `error` lines follow at
~1/s (the firmware retries forever — it's useless without the seesaw) until
init succeeds, then `boot`/`stage":"ready"` is sent once the startup LED
sweep finishes; `attempts` is how many `error` lines preceded it. None of
these three mutate slot state — the bridge only logs them. See
`docs/design/wrong-firmware-recovery-plan.md` for why this exists (a hung
seesaw and the wrong firmware both used to look identical: dark keys, no
serial output).

`agent.select` now also brings that slot's Terminal window to front if it
already has a live session (confirmed working) — not just on first launch.
`agent.focus` does the same thing without changing the selected slot, for a
future case where those two need to be separate actions. `agent.update.ack`
is sent by the firmware every time it applies an `agent.update` (see below),
so `sync_device` can confirm the screen actually picked up a push.

Bridge -> board:

```json
{"event":"agent.update","slot":1,"name":"Maestro","family":"claude","status":"working","effort":"medium","activity":"","busy_elapsed_ms":12345}
{"event":"led.config","idle_pulse_ms":7000,"busy_ramp_ms":90000}
```

`busy_elapsed_ms` is only nonzero while `status` is `working`/`thinking`,
and measures the **current turn** — it resets to 0 on every
`UserPromptSubmit`, even mid-turn. It's sent only on an actual change
(status/effort/name, a slot freeing up, a key select, bridge startup, or the
`sync` command) — never on a timer; the firmware advances the ramp locally
between pushes using the elapsed time it derives from this value plus its
own `millis()`.

`led.config` is board-wide (not per-slot) and sent once at bridge startup
plus whenever these settings change — see "LED pulse settings" below. An
older firmware that doesn't recognise the event name just ignores the line
(`pollIncomingSerial` silently drops any unmatched `event`), so this is
safe to send regardless of what's actually flashed.

## LED pulse settings

Two board-wide presets, editable from the settings web UI (`switchboard
settings`) or by hand in `agents.json`'s `"leds"` object:

```json
"leds": { "idle_breathe": "slow", "thinking_cycle": "quick" }
```

- **`idle_breathe`**: `"off"` (solid — the firmware's own default),
  `"slow"` (7s, a "giant breath"), or `"medium"` (4s). Applies
  `led_model.h`'s existing raised-cosine breathing wave (already used for
  `needs_input`'s blink and the busy ramp's pulse) to the otherwise-solid
  `idle` status.
- **`thinking_cycle`**: `"quick"` (90s), `"normal"` (5min — the original,
  unconfigured default), or `"slow"` (10min). Controls how long the busy
  ramp (`thinking`/`working`'s white -> blue -> magenta color sweep, and
  how fast its own pulse speeds up along the way) takes end to end.

Both resolve host-side (`switchboard.settings.led_config_wire`) to the raw
millisecond values in the `led.config` event above — the board only ever
sees numbers, never preset names, so new presets can be added later
without touching firmware. Takes effect within a few seconds of saving
(the bridge's normal settings-reload tick); no relaunch or reflash needed
for a settings change, only for the firmware feature itself to exist on a
given board.

## Intended future events

```json
{"event":"plan.approve","slot":1}
{"event":"review.request","slot":1}
{"event":"slash.run","slot":1,"command":"/review"}
```

## TODO: token-consumption LED pattern

Idea, not yet designed or implemented: layer in something driven by real
token usage per slot on top of the existing `busy_elapsed_ms`-based duration
escalation — e.g. the LED pattern gets more intense/urgent the more tokens a
turn has burned, not just how long it's taken. Needs the hook payload body
to actually be parsed further (today only a handful of fields are read) and
`transcript_path` read for per-turn `usage` data — a real lift, not a quick
add.

## Running the tests

```sh
host/.venv/bin/pip install -r host/requirements-dev.txt
host/.venv/bin/python -m pytest host/tests -q
```

Covers the registry transaction/locking, the pure reducer (including
`busy_elapsed_ms` and the `session_id` ownership guard), process liveness
probing, the CLI, and end-to-end integration tests over a real pty + hook
server. No board or running bridge needed.

### Golden traces

`host/tests/golden/*.in.jsonl` each replay one sequence of board/hook/
liveness events through a real `Bridge.step()` (no threads, no sleeps) and
compare the exact device output to the matching `*.out.jsonl` — see
`test_golden.py`'s module docstring for the input line grammar. To review
and update them after a deliberate behavior change:

```sh
host/.venv/bin/python -m pytest host/tests/test_golden.py --update-golden
git diff host/tests/golden  # review before committing
```

### Firmware

The firmware's pure LED logic (`firmware/neokey/led_model.h`) has its own
host-side test, no Arduino toolchain required:

```sh
firmware/neokey/test/run.sh
```

A compile-only check (catches build breaks without a board attached; needs
`arduino-cli`, the esp32 core, "Adafruit seesaw Library", and ArduinoJson):

```sh
firmware/neokey/test/compile.sh
```

## Safety rule

Mutating actions stay inert until the bridge has an explicit implementation and a deliberate confirmation path. The firmware can emit a requested action, but this bridge only reports it.
