mknudsen404-QA/4KeyPOC/hardware/enclosure/4key_case_plate.stl

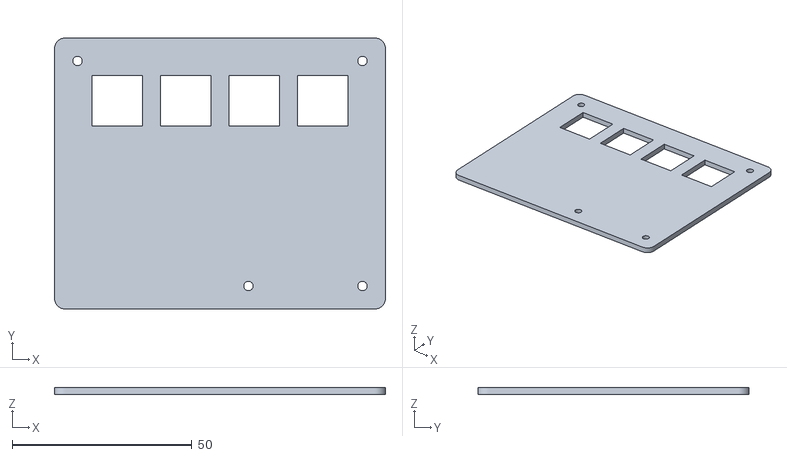
[picture p1: CAD file, 2026-10-04]
hardware/enclosure/4key_case_plate.stl
92.0 x 75.3 x 2.00
