mknudsen404-QA/4KeyPOC/hardware/enclosure/4key_case_tray.stl

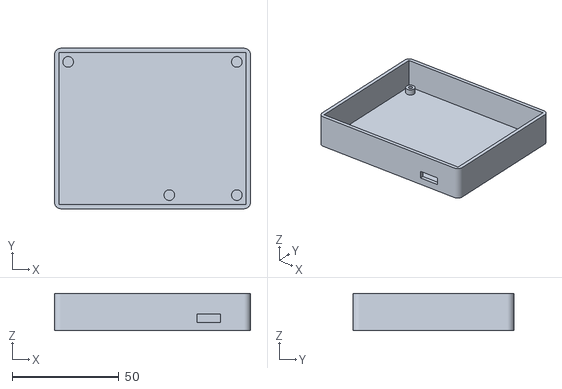
[picture p2: CAD file, 2026-10-04]
hardware/enclosure/4key_case_tray.stl
92.0 x 75.3 x 17.6
