mknudsen404-QA/4KeyPOC/hardware/enclosure/8key_badge.stl

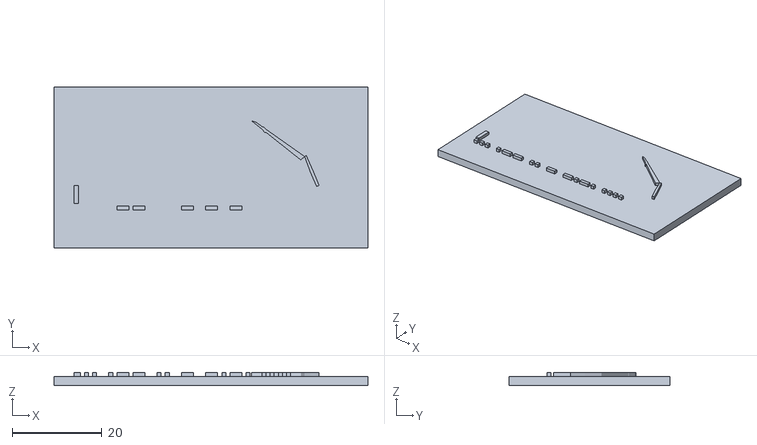
[picture p3: CAD file, 2026-09-13]
hardware/enclosure/8key_badge.stl
70.0 x 36.0 x 2.80
