mknudsen404-QA/4KeyPOC/(list of files, cad)

Other CAD files:
hardware/enclosure/12key_badge.stl
hardware/enclosure/4key_badge.scad
hardware/enclosure/8key_badge.scad
