mknudsen404-QA/4KeyPOC/hardware/kicad/8key/8key.kicad_pcb

## KiCad design hardware/kicad/8key/8key.kicad_pcb (2026-10-15)

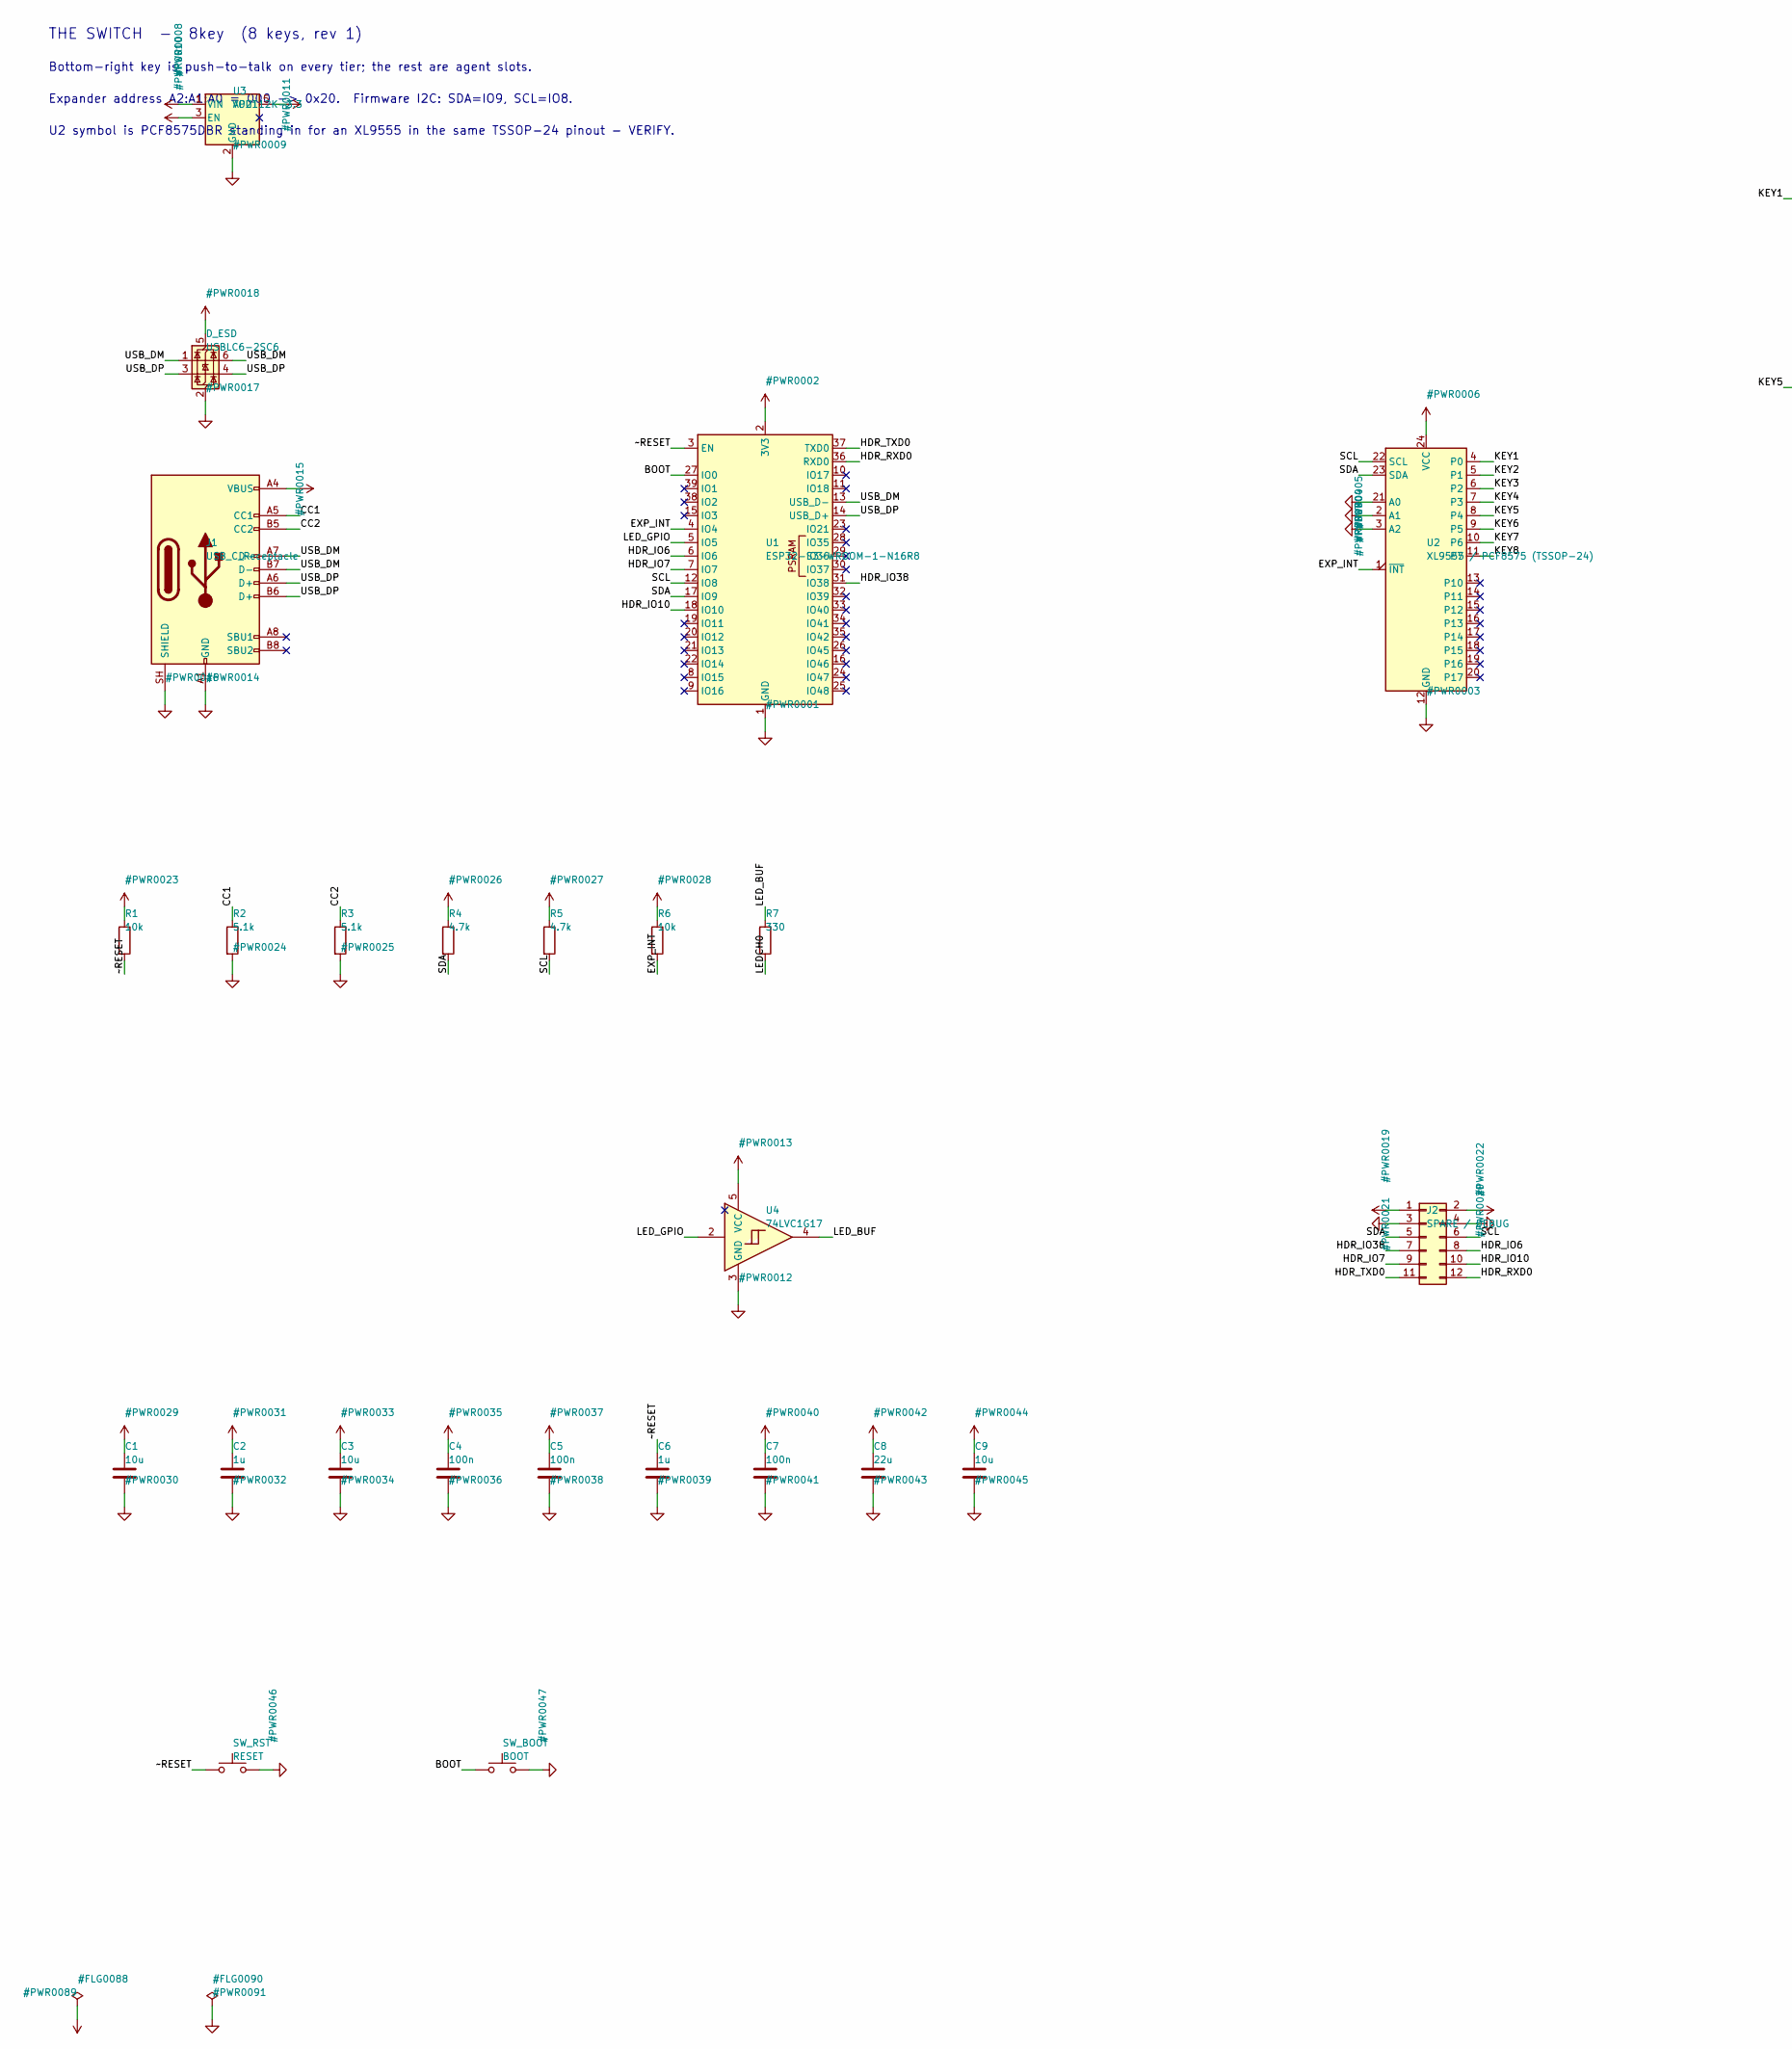
[picture p5: schematic 8key.kicad_sch, THE SWITCH - 8key agent-status keypad, part in row 1, column 1]

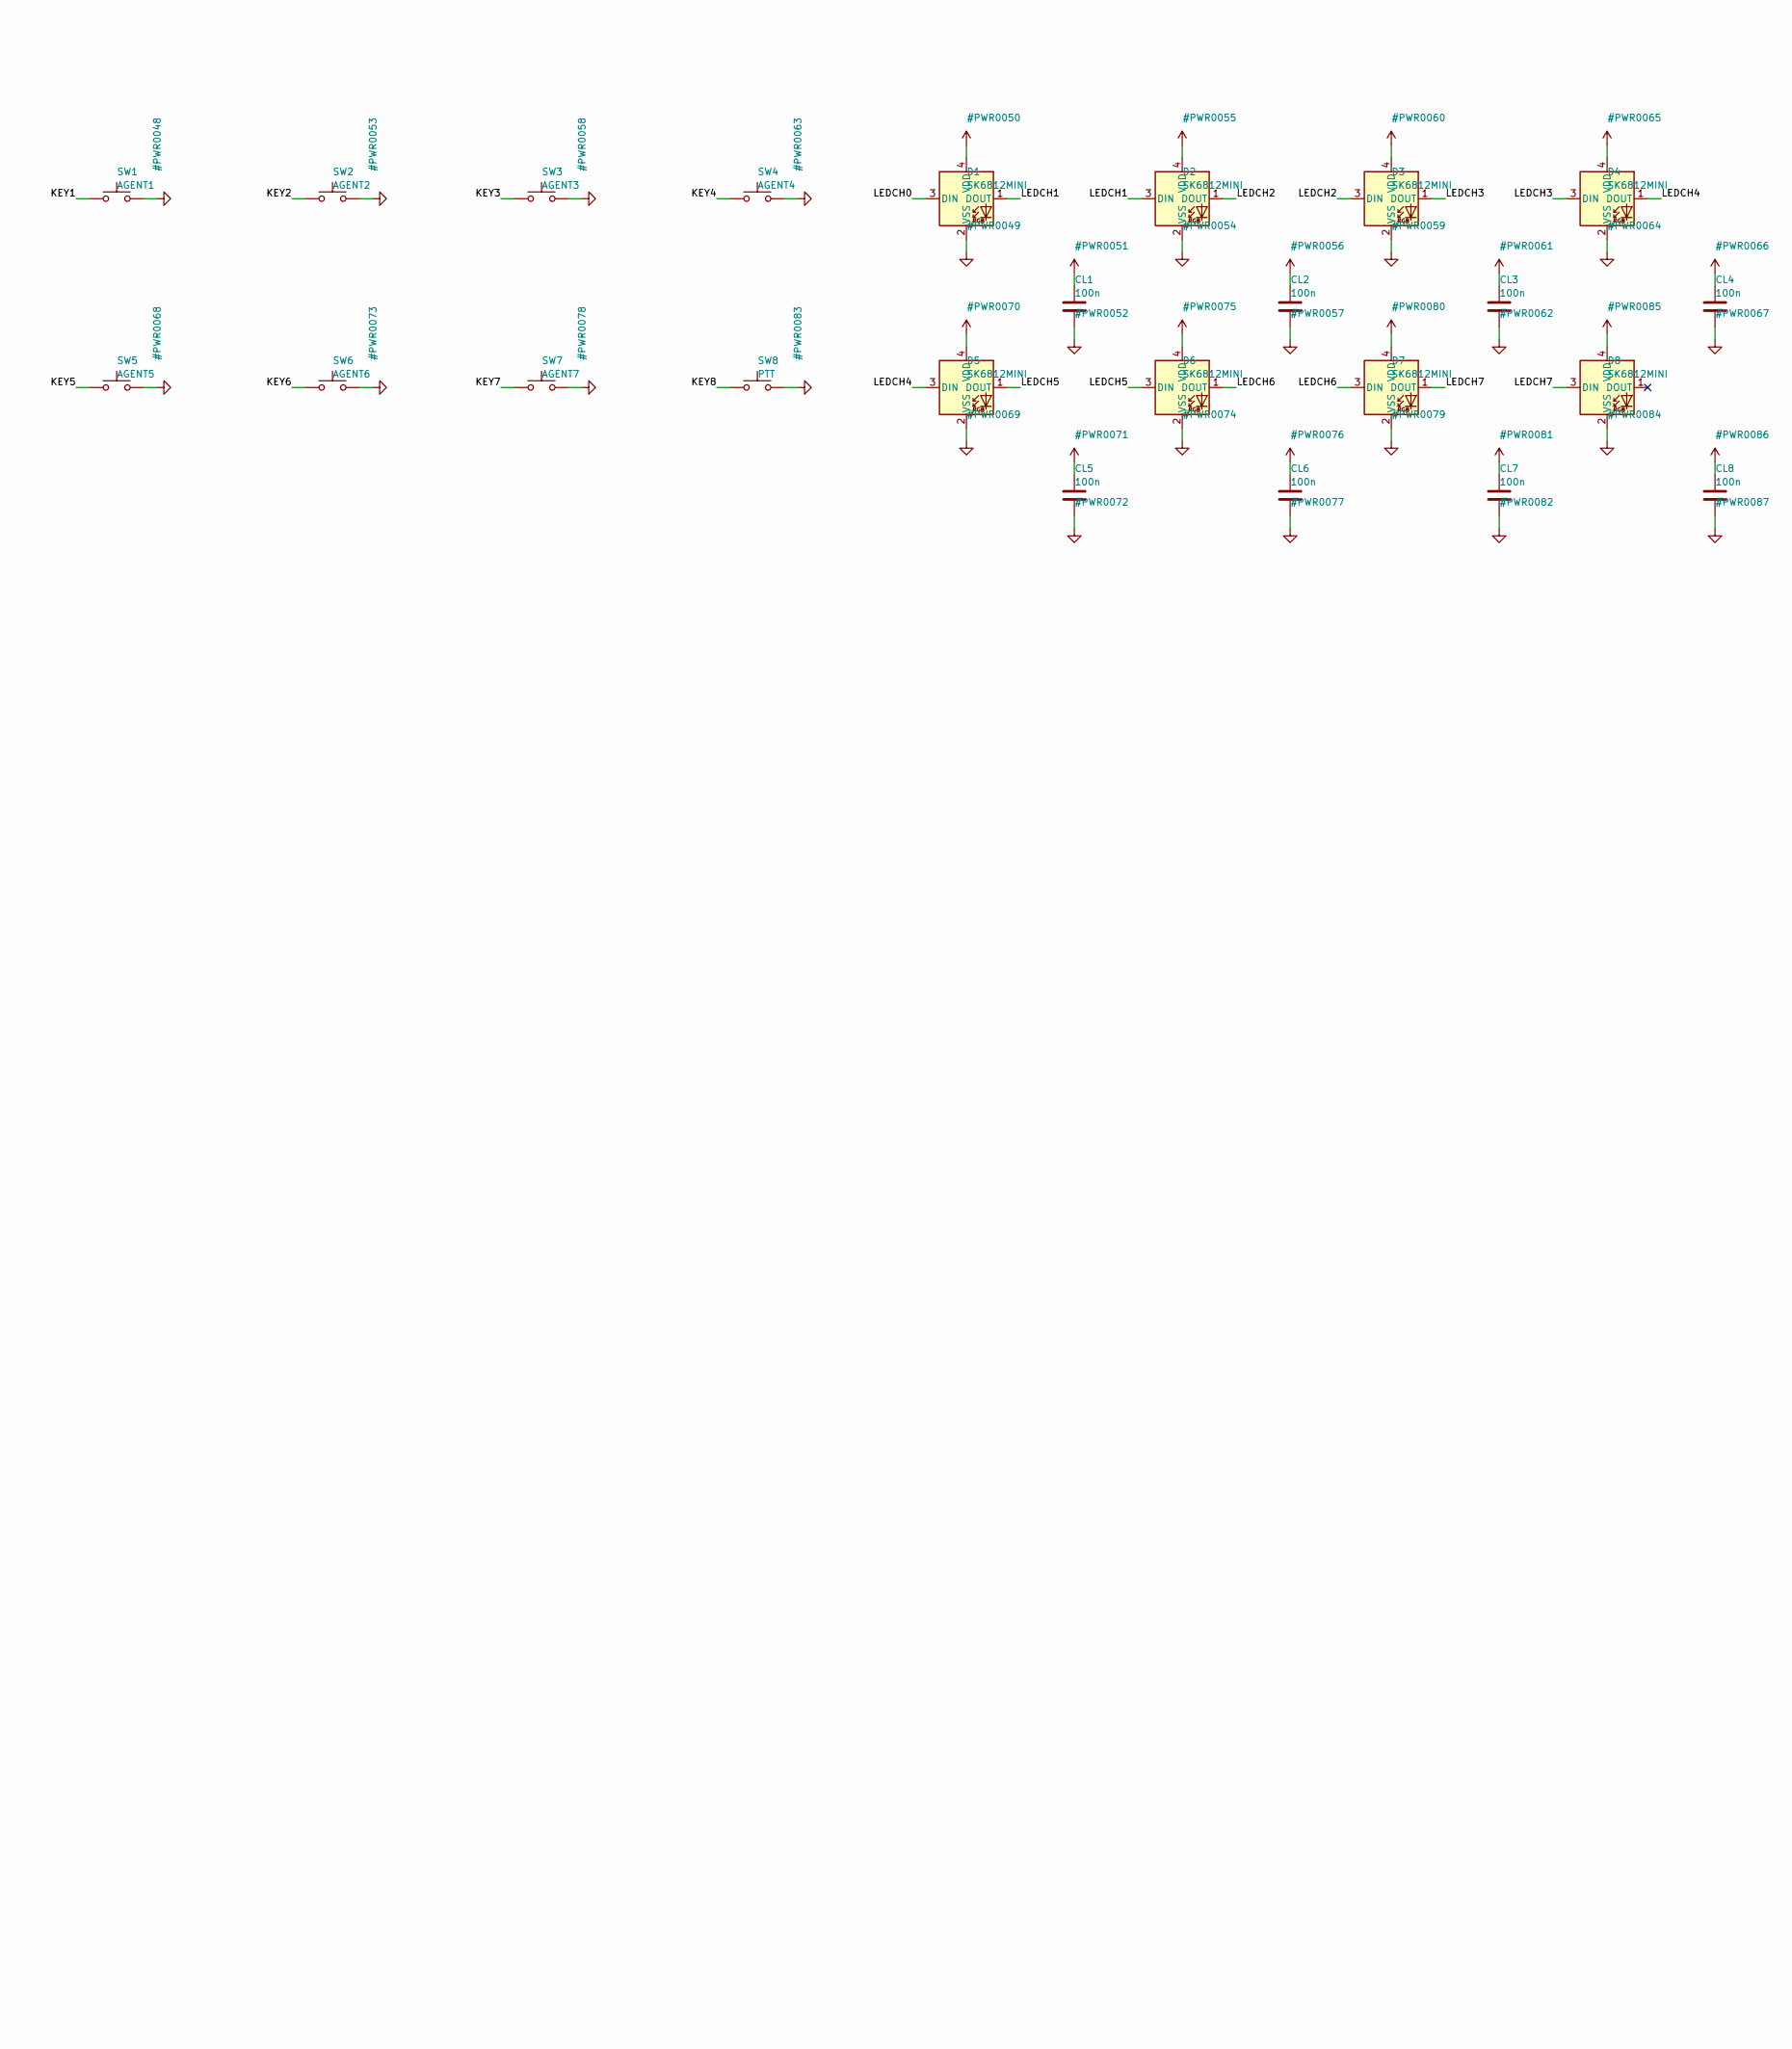
[picture p6: schematic 8key.kicad_sch, THE SWITCH - 8key agent-status keypad, part in row 1, column 2]

Parts:
C1, C3, C9: 10u; C_0805_2012Metric_Pad1.18x1.45mm_HandSolder
C2, C6: 1u; C_0603_1608Metric_Pad1.08x0.95mm_HandSolder
C4, C5, C7: 100n; C_0603_1608Metric_Pad1.08x0.95mm_HandSolder
C8: 22u; C_0805_2012Metric_Pad1.18x1.45mm_HandSolder
CL1, CL2, CL3, CL4, CL5, CL6, CL7, CL8: 100n; C_0603_1608Metric_Pad1.08x0.95mm_HandSolder
D1, D2, D3, D4, D5, D6, D7, D8: SK6812MINI; LED_SK6812MINI_PLCC4_3.5x3.5mm_P1.75mm
D_ESD: USBLC6-2SC6; SOT-23-6
J1: USB_C_Receptacle; USB_C_Receptacle_HCTL_HC-TYPE-C-16P-01A
J2: SPARE / DEBUG; PinHeader_2x06_P2.54mm_Vertical
R1, R6: 10k; R_0603_1608Metric_Pad0.98x0.95mm_HandSolder
R2, R3: 5.1k; R_0603_1608Metric_Pad0.98x0.95mm_HandSolder
R4, R5: 4.7k; R_0603_1608Metric_Pad0.98x0.95mm_HandSolder
R7: 330; R_0603_1608Metric_Pad0.98x0.95mm_HandSolder
SW1: AGENT1; SW_Hotswap_Kailh_MX
SW2: AGENT2; SW_Hotswap_Kailh_MX
SW3: AGENT3; SW_Hotswap_Kailh_MX
SW4: AGENT4; SW_Hotswap_Kailh_MX
SW5: AGENT5; SW_Hotswap_Kailh_MX
SW6: AGENT6; SW_Hotswap_Kailh_MX
SW7: AGENT7; SW_Hotswap_Kailh_MX
SW8: PTT; SW_Hotswap_Kailh_MX
SW_BOOT: BOOT; SW_Push_1P1T_NO_CK_KMR2
SW_RST: RESET; SW_Push_1P1T_NO_CK_KMR2
U1: ESP32-S3-WROOM-1-N16R8; ESP32-S3-WROOM-1
U2: XL9555 / PCF8575 (TSSOP-24); TSSOP-24_4.4x7.8mm_P0.65mm
U3: AP2112K-3.3; SOT-23-5
U4: 74LVC1G17; SOT-23-5

Connections:
+3V3: C3.1, C4.1, C5.1, C9.1, J2.1, R1.1, R4.1, R5.1, R6.1, U1.2 (3V3), U2.24 (VCC), U3.5 (VOUT)
+5V: C1.1, C2.1, C7.1, C8.1, CL1.1, CL2.1, CL3.1, CL4.1, CL5.1, CL6.1, CL7.1, CL8.1, D1.4 (VDD), D2.4 (VDD), D3.4 (VDD), D4.4 (VDD), D5.4 (VDD), D6.4 (VDD), D7.4 (VDD), D8.4 (VDD), D_ESD.5 (VBUS), J1.A4 (VBUS), J1.A9 (VBUS), J1.B4 (VBUS), J1.B9 (VBUS), J2.2, U3.1 (VIN), U3.3 (EN), U4.5 (VCC)
BOOT: SW_BOOT.1, U1.27 (IO0)
CC1: J1.A5 (CC1), R2.1
CC2: J1.B5 (CC2), R3.1
EXP_INT: R6.2, U1.4 (IO4), U2.1 (~INT)
GND: C1.2, C2.2, C3.2, C4.2, C5.2, C6.2, C7.2, C8.2, C9.2, CL1.2, CL2.2, CL3.2, CL4.2, CL5.2, CL6.2, CL7.2, CL8.2, D1.2 (VSS), D2.2 (VSS), D3.2 (VSS), D4.2 (VSS), D5.2 (VSS), D6.2 (VSS), D7.2 (VSS), D8.2 (VSS), D_ESD.2 (GND), J1.A1 (GND), J1.A12 (GND), J1.B1 (GND), J1.B12 (GND), J1.SH (SHIELD), J2.3, J2.4, R2.2, R3.2, SW1.2, SW2.2, SW3.2, SW4.2, SW5.2, SW6.2, SW7.2, SW8.2, SW_BOOT.2, SW_RST.2, U1.1 (GND), U1.40 (GND), U1.41 (GND), U2.2 (A1), U2.3 (A2), U2.12 (GND), U2.21 (A0), U3.2 (GND), U4.3 (GND)
HDR_IO6: J2.8, U1.6 (IO6)
HDR_IO7: J2.9, U1.7 (IO7)
HDR_IO10: J2.10, U1.18 (IO10)
HDR_IO38: J2.7, U1.31 (IO38)
HDR_RXD0: J2.12, U1.36 (RXD0)
HDR_TXD0: J2.11, U1.37 (TXD0)
KEY1: SW1.1, U2.4 (P0)
KEY2: SW2.1, U2.5 (P1)
KEY3: SW3.1, U2.6 (P2)
KEY4: SW4.1, U2.7 (P3)
KEY5: SW5.1, U2.8 (P4)
KEY6: SW6.1, U2.9 (P5)
KEY7: SW7.1, U2.10 (P6)
KEY8: SW8.1, U2.11 (P7)
LEDCH0: D1.3 (DIN), R7.2
LEDCH1: D1.1 (DOUT), D2.3 (DIN)
LEDCH2: D2.1 (DOUT), D3.3 (DIN)
LEDCH3: D3.1 (DOUT), D4.3 (DIN)
LEDCH4: D4.1 (DOUT), D5.3 (DIN)
LEDCH5: D5.1 (DOUT), D6.3 (DIN)
LEDCH6: D6.1 (DOUT), D7.3 (DIN)
LEDCH7: D7.1 (DOUT), D8.3 (DIN)
LED_BUF: R7.1, U4.4
LED_GPIO: U1.5 (IO5), U4.2
SCL: J2.6, R5.2, U1.12 (IO8), U2.22 (SCL)
SDA: J2.5, R4.2, U1.17 (IO9), U2.23 (SDA)
USB_DM: D_ESD.1 (I/O1), D_ESD.6 (I/O1), J1.A7 (D-), J1.B7 (D-), U1.13 (USB_D-)
USB_DP: D_ESD.3 (I/O2), D_ESD.4 (I/O2), J1.A6 (D+), J1.B6 (D+), U1.14 (USB_D+)
~RESET: C6.1, R1.2, SW_RST.1, U1.3 (EN)

Notes on the sheet:
THE SWITCH - 8key (8 keys, rev 1)
Bottom-right key is push-to-talk on every tier; the rest are agent slots.
Expander address A2:A1:A0 = 000 -> 0x20. Firmware I2C: SDA=IO9, SCL=IO8.
U2 symbol is PCF8575DBR standing in for an XL9555 in the same TSSOP-24 pinout - VERIFY.

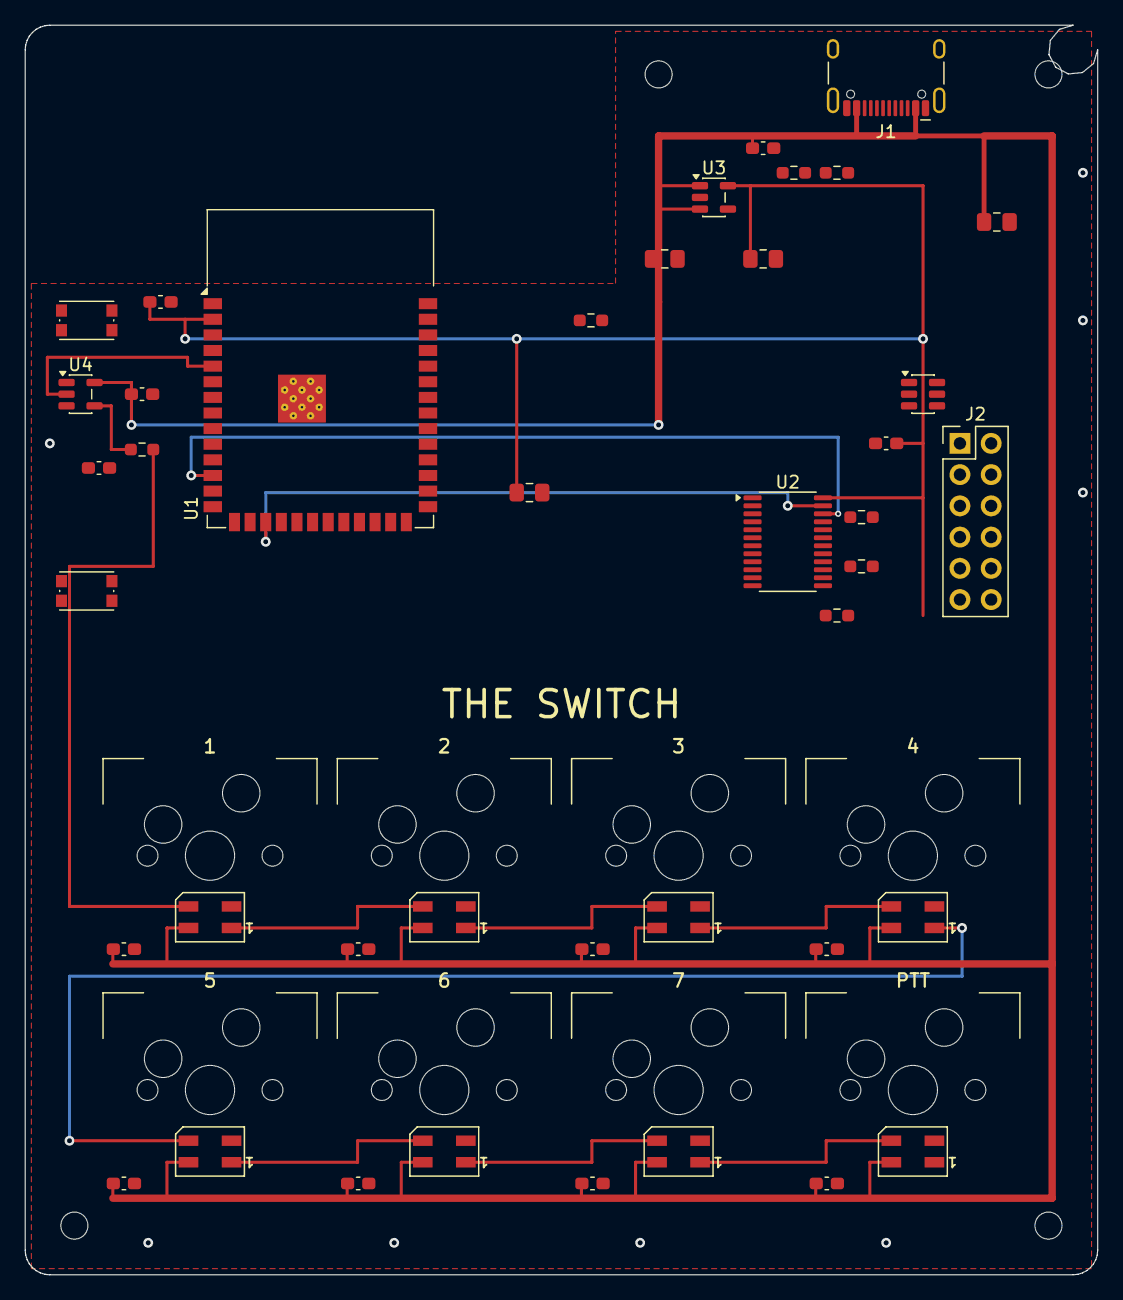
[picture p7: board 8key.kicad_pcb from above]

Board: 2 copper layers, 87.2 x 101.6 mm, 53 parts (0 on the bottom side), 36 nets.

Other parts of the board:
H50, H51, H52, H53: MountingHole_2.2mm_M2
