mknudsen404-QA/4KeyPOC/firmware/neokey/neokey.ino

#include <Wire.h>
#include <math.h>
#include <ArduinoJson.h>
#include "Adafruit_NeoKey_1x4.h"
#include "seesaw_neopixel.h"
#include "led_model.h"

// Composite USB (CDC, the runtime protocol above, + MSC, a tiny
// read-only installer drive) — see
// docs/design/plug-and-play-installer-plan.md. Merged in from the
// validated firmware/msc_cdc_spike/ spike (2026-09-12); this #error
// guard is carried over from that spike so a board built with the wrong
// USB Mode fails the build loudly instead of silently shipping a board
// that can't advertise the installer drive.
#ifndef ARDUINO_USB_MODE
#error This sketch requires an ESP32-S3 (or other SoC with native USB)
#elif ARDUINO_USB_MODE == 1
#error Set "USB Mode" to "USB-OTG (TinyUSB)", not "Hardware CDC and JTAG"
#endif
#include "USB.h"
#include "USBMSC.h"
#include "installer_disk.h"

#define FIRMWARE_NAME "neokey"
#define FIRMWARE_BUILD __DATE__ " " __TIME__

#define NEOKEY_ADDR 0x30
#define SDA_PIN 9
#define SCL_PIN 8

// Keys A, B, C (indices 0-2) are agent-select keys mapped to Switchboard
// slots 1-2-3. Key D (index 3) is push-to-talk for whichever slot is
// currently selected.
#define AGENT_KEY_COUNT 3
#define PTT_KEY_INDEX 3
const uint8_t AGENT_SLOTS[AGENT_KEY_COUNT] = {1, 2, 3};

Adafruit_NeoKey_1x4 neokey;

// --- Installer drive (MSC) --------------------------------------------
// Read-only virtual drive backed by a compiled-in FAT image (see
// gen_fat.py / installer_disk.h) carrying one file: a double-clickable
// installer stub. Coexists with the CDC serial protocol below — both
// ride the same native USB peripheral, enumerated together by the one
// USB.begin() call in setup().
USBMSC MSC;

static int32_t mscOnRead(uint32_t lba, uint32_t offset, void *buffer, uint32_t bufsize) {
  memcpy(buffer, msc_disk_image + (lba * DISK_SECTOR_SIZE) + offset, bufsize);
  return bufsize;
}

static int32_t mscOnWrite(uint32_t lba, uint32_t offset, uint8_t *buffer, uint32_t bufsize) {
  // Read-only volume: silently accept and discard writes (some OSes probe
  // writability during mount). Never persists anything.
  return bufsize;
}

static bool mscOnStartStop(uint8_t power_condition, bool start, bool load_eject) {
  return true;
}

int selectedSlot = 0;  // 0 = none selected yet
Status slotStatus[AGENT_KEY_COUNT] = {Status::Empty, Status::Empty, Status::Empty};
unsigned long slotBusyStartMs[AGENT_KEY_COUNT] = {0, 0, 0};
// Set from each update's "liveness" field: "unknown" -> true, "alive" or
// the field being absent (a status-driven update, e.g. from a hook, which
// only happens if the process is alive) -> false.
bool slotUncertain[AGENT_KEY_COUNT] = {false, false, false};
bool ptt_held = false;

// Runtime LED pulse settings (see led.config below) — board-wide, applied
// to every key. Defaults match led_model.h's own compiled-in behavior
// (solid idle, the original 5-minute busy ramp), so a board that never
// receives a led.config line (older bridge, or none connected yet)
// renders exactly as it always has.
unsigned long idlePulseOverrideMs = 0;
uint32_t busyRampMs = BUSY_RAMP_MS;

void redrawAgentKeys() {
  unsigned long now = millis();
  for (uint8_t i = 0; i < AGENT_KEY_COUNT; i++) {
    bool isSelected = (selectedSlot == AGENT_SLOTS[i]);
    uint32_t elapsed = statusIsBusy(slotStatus[i]) ? (uint32_t)(now - slotBusyStartMs[i]) : 0;
    neokey.pixels.setPixelColor(i, renderKey(slotStatus[i], elapsed, isSelected, now, slotUncertain[i], busyRampMs, idlePulseOverrideMs));
  }
}

void sendEvent(const char *eventName, int slot) {
  StaticJsonDocument<128> doc;
  doc["event"] = eventName;
  doc["slot"] = slot;
  serializeJson(doc, Serial);
  Serial.println();
}

// Boot/error diagnostics have nothing to do with slots, so they get their
// own senders rather than overloading slot-keyed sendEvent().
void sendBootEvent(const char *stage, int attempts) {
  StaticJsonDocument<192> doc;
  doc["event"] = "boot";
  doc["stage"] = stage;
  doc["firmware"] = FIRMWARE_NAME;
  if (strcmp(stage, "ready") == 0) {
    doc["attempts"] = attempts;
  } else {
    doc["build"] = FIRMWARE_BUILD;
  }
  serializeJson(doc, Serial);
  Serial.println();
}

void sendSeesawErrorEvent(int attempt) {
  StaticJsonDocument<128> doc;
  doc["event"] = "error";
  doc["reason"] = "seesaw_no_response";
  doc["attempt"] = attempt;
  serializeJson(doc, Serial);
  Serial.println();
}

// Non-blocking line reader for incoming bridge JSON (agent.update events).
void pollIncomingSerial() {
  static char lineBuf[384];
  static size_t lineLen = 0;

  while (Serial.available() > 0) {
    char c = (char)Serial.read();
    if (c == '\n') {
      lineBuf[lineLen] = '\0';
      if (lineLen > 0) {
        StaticJsonDocument<384> doc;
        DeserializationError err = deserializeJson(doc, lineBuf);
        if (!err) {
          const char *eventName = doc["event"] | "";
          if (strcmp(eventName, "agent.update") == 0) {
            int slot = doc["slot"] | 0;
            const char *status = doc["status"] | "empty";
            // busy_seconds is accepted for one release as a fallback while
            // any bridge that hasn't been restarted yet is still sending it.
            uint32_t busyElapsedMs = doc["busy_elapsed_ms"] | (uint32_t)(doc["busy_seconds"] | 0) * 1000UL;
            bool uncertain = strcmp(doc["liveness"] | "", "unknown") == 0;
            for (uint8_t i = 0; i < AGENT_KEY_COUNT; i++) {
              if (AGENT_SLOTS[i] == slot) {
                slotStatus[i] = statusFromString(status);
                slotBusyStartMs[i] = millis() - busyElapsedMs;
                slotUncertain[i] = uncertain;
              }
            }
            sendEvent("agent.update.ack", slot);
          } else if (strcmp(eventName, "led.config") == 0) {
            // Board-wide, applied on the next redrawAgentKeys() — no ack
            // needed (unlike agent.update, nothing tracks delivery of this
            // one; a value here is harmlessly re-sent on every bridge
            // settings reload regardless of whether it actually changed).
            idlePulseOverrideMs = doc["idle_pulse_ms"] | 0UL;
            busyRampMs = doc["busy_ramp_ms"] | (uint32_t)BUSY_RAMP_MS;
          }
        }
      }
      lineLen = 0;
    } else if (lineLen < sizeof(lineBuf) - 1) {
      lineBuf[lineLen++] = c;
    }
  }
}

void setup() {
  Serial.begin(115200);

  // Enumerate the installer drive before the seesaw init below, which can
  // block indefinitely in its retry loop if the NeoKey chip doesn't
  // answer — the installer drive should still appear even then, since a
  // stuck seesaw chip is exactly the kind of hardware hiccup this
  // shouldn't be coupled to. One USB.begin() call enumerates both this
  // (MSC) and the Serial/CDC above together.
  MSC.vendorID("Switchbd");
  MSC.productID("Installer");
  MSC.productRevision("1.0");
  MSC.onRead(mscOnRead);
  MSC.onWrite(mscOnWrite);
  MSC.onStartStop(mscOnStartStop);
  MSC.mediaPresent(true);
  MSC.isWritable(false);
  MSC.begin(DISK_SECTOR_COUNT, DISK_SECTOR_SIZE);
  USB.begin();

  delay(2000);

  sendBootEvent("start", 0);

  Wire.begin(SDA_PIN, SCL_PIN);

  // NOTE: we deliberately do NOT call neokey.begin() here. That function
  // issues a seesaw software-reset (SWRST) before doing anything else, and on
  // this board that reset reliably leaves the chip unable to answer any
  // further register reads (confirmed with a raw I2C diagnostic sketch) even
  // though plain reads/writes work fine otherwise. So we replicate begin()'s
  // steps manually, skipping the reset call.
  bool ok = false;
  int attempt = 0;
  while (!ok) {
    ok = neokey.pixels.Adafruit_seesaw::begin(NEOKEY_ADDR, -1, false) &&
         neokey.Adafruit_seesaw::begin(NEOKEY_ADDR, -1, false);
    if (!ok) {
      attempt++;
      sendSeesawErrorEvent(attempt);
      delay(1000);
    }
  }

  neokey.pixels.updateType(NEO_GRB + NEO_KHZ800);
  neokey.pixels.updateLength(4);
  neokey.pixels.setPin(NEOKEY_1X4_NEOPIN);
  neokey.pixels.setBrightness(40);
  neokey.pixels.show();
  delay(5);

  neokey.pinModeBulk(NEOKEY_1X4_BUTTONMASK, INPUT_PULLUP);
  neokey.setGPIOInterrupts(NEOKEY_1X4_BUTTONMASK, 1);

  // Startup light sweep so you get visual confirmation without the monitor open
  for (uint16_t i = 0; i < neokey.pixels.numPixels(); i++) {
    neokey.pixels.setPixelColor(i, 0x808080);
    neokey.pixels.show();
    delay(80);
  }
  for (uint16_t i = 0; i < neokey.pixels.numPixels(); i++) {
    neokey.pixels.setPixelColor(i, 0);
    neokey.pixels.show();
    delay(80);
  }

  sendBootEvent("ready", attempt);
}

uint8_t lastButtons = 0;

void loop() {
  pollIncomingSerial();

  uint8_t buttons = neokey.read();
  uint8_t pressedEdge = buttons & ~lastButtons;   // bits that just went from 0->1
  uint8_t releasedEdge = ~buttons & lastButtons;  // bits that just went from 1->0
  lastButtons = buttons;

  for (uint8_t i = 0; i < AGENT_KEY_COUNT; i++) {
    if (pressedEdge & (1 << i)) {
      selectedSlot = AGENT_SLOTS[i];
      sendEvent("agent.select", selectedSlot);
    }
  }

  if (pressedEdge & (1 << PTT_KEY_INDEX)) {
    ptt_held = true;
    sendEvent("voice.hold.start", selectedSlot);
  }
  if (releasedEdge & (1 << PTT_KEY_INDEX)) {
    ptt_held = false;
    sendEvent("voice.hold.stop", selectedSlot);
  }

  redrawAgentKeys();
  neokey.pixels.setPixelColor(PTT_KEY_INDEX, ptt_held ? 0xFF00FF : 0);
  neokey.pixels.show();

  delay(10);
}
