mknudsen404-QA/4KeyPOC/(commit log)

2026-09-13 Initial commit: Switchboard host bridge + Codex Micro display firmware
    Mac-side bridge (host/switchboard_bridge.py) that maps physical agent keys
    to launched Claude/Codex CLI sessions, tracks status via real lifecycle
    hooks, and drives per-key LED status/duration escalation over serial.
    Includes the ESP32-S3 LVGL display firmware this was originally built for.
    [partitions-16MiB.csv]
2026-09-13 Claim exclusive serial access; fix voice-hold; focus terminal on re-select
    - open_serial() now uses TIOCEXCL so a second process (stray cat, another
    bridge instance) gets a loud "Resource busy" instead of silently
    splitting incoming bytes with the bridge. Root-caused a real debugging
    session where a leftover diagnostic `cat` starved the bridge of every
    board event with no visible error on either side.
    - agent.select now focuses an already-running slot's Terminal window/tab,
    not just newly-launched ones.
    - voice.hold no longer tries to auto-toggle Claude's /voice mode by
    tailing the terminal log for its enabled/disabled message — that's
    unreliable against Claude Code's full-sc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
2026-09-13 Add NeoKey firmware to the repo; fix status color palette
    - firmware/neokey/: the actual ESP32-S3 + NeoKey 1x4 client sketch, with a
    README covering board setup and the seesaw-reset workaround (previously
    only lived outside this project's folder).
    - Reserve red for "blocked" (a real error) only. needs_input/waiting were
    mapped to red too, which reads as "something's wrong" even for routine
    cases like Claude Code's first-run trust-this-folder prompt — changed to
    yellow.
2026-09-13 Polish setup.sh: colored status output, prerequisite checks, clean summary
    - macOS/python3 checks up front with a clear error instead of failing
    deep into a step with a raw traceback.
    - Color-coded step/ok/skip/warn output (falls back to plain text when
    not attached to a tty, e.g. piped into a log).
    - ERR trap gives a clear "safe to re-run" message instead of bash's
    default error output.
    - Final summary block instead of scattered prints.
2026-09-13 Add plug-and-play installer project plan; update repo name references
    Repo renamed to 4KeyPOC and made public (needed so a future double-clicked
    installer stub can clone it with zero auth friction) — this reflects that
    in the setup docs. Also adds docs/design/plug-and-play-installer-plan.md,
    scoping the composite USB CDC+MSC device + installer-stub project for a
    real "plug in, one-click install, works forever" first-time experience.
    Not started — this is the plan, not the implementation.
2026-09-13 Resolve plug-and-play installer spike open questions; add composite CDC+MSC spike sketch
    Confirmed via read-only esptool query (16MB flash/8MB PSRAM on the working
    board) and a compile-verified standalone sketch that the installed
    Arduino-ESP32 core (3.3.11) supports composite CDC+MSC cleanly, and that
    the MSC volume can live entirely in RAM rather than needing a dedicated
    flash partition. Spike sketch is separate from codex_micro_neokey.ino and
    not yet flashed to hardware.
    Claude-Session: https://claude.ai/code/session_01G3UGFoayrhE4nAdAucSj3n
    [msc_cdc_spike.ino]
2026-09-13 Validate composite CDC+MSC installer spike on real hardware with the actual .command stub
    Adds a VFAT long-filename FAT12 generator (gen_fat.py) so the MSC volume
    can carry a real "Install Switchboard.command" file instead of an 8.3-only
    placeholder, and the real installer stub itself (checks for an existing
    install, prompts via a native dialog, clones the repo, runs host/setup.sh).
    Flashed to the working NeoKey board with explicit sign-off and validated
    end-to-end: composite CDC+MSC enumeration, correct long filename and
    byte-identical content, CDC staying alive throughout, and the installer's
    "already installed" branch running correctly live. Reflashed
    codex_micro_neokey.ino back afterwar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
    [gen_fat.py, msc_cdc_spike.ino]
2026-09-13 4Key: duration-based hue/pulse for busy status, fix false "blocked" reds
    Working/thinking status now sweeps continuously from cool blue through
    purple/magenta to warm ember-orange over 5 minutes (deliberately routed
    around green/yellow so it never masquerades as done/waiting mid-ramp),
    with a smooth cosine breathing pulse that quickens alongside it, rather
    than a fixed color and hard 20s/60s pulse-speed thresholds.
    Also removes the bridge's error/traceback log-scan heuristic that was
    flashing keys red during ordinary subagent runs on any benign mention
    of those words in the terminal log tail.
    Claude-Session: https://claude.ai/code/ses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
2026-09-13 Add 4/8/12Key business plan and KiCad hardware; fix Stop-vs-subagent status race; finish Switchboard rename
    Business: log the tiered 4Key/8Key/12Key product-line idea and the
    "watch it get built" buying experience, plus a full business plan
    (pricing, ops, go-to-market, risks) grounded in the actual repo state.
    Hardware: three real KiCad 10 projects (4key/8key/12key) generated from
    one shared part/net table -- ESP32-S3-WROOM-1, I2C GPIO expander,
    WS2812/SK6812 LED chain, hot-swap MX sockets -- clean ERC/DRC on all
    three, plus a 3D-printable enclosure badge per tier carrying the
    carrot-and-stick version-identification easter eggs (Morse tier name,
    thumb-countable revision tally, advancing mas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
    [12key.kicad_pcb, 12key.kicad_sch, 12key_badge.scad, 12key_badge.stl, 4key.kicad_pcb, 4key.kicad_sch, 4key_badge.scad, 4key_badge.stl]
2026-09-13 Fix stale LED colors on 4Key: remove shared registry cache, lock serial writes
    BridgeState.registry was loaded once at startup and only refreshed
    opportunistically by poll_slot_logs, while the HTTP hook server wrote
    lifecycle-hook status changes straight to disk without updating that
    cached copy. Anything reading state.registry (agent.select/focus/
    reasoning.apply) could repaint a key's LED from stale data — showing a
    leftover status until the next poll tick corrected it, or getting stuck
    indefinitely for non-busy slots the poller never re-pushes.
    describe_event and friends now load the registry fresh from disk at
    every use instead of caching it on BridgeState. Also added a lock
    around th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
2026-09-13 Phase 0.1-0.2: test scaffold, clock seam, atomic locked registry
    - Add host/tests with conftest fixtures (fake clock, capture_device,
    hook_body) and real Claude Code hook payload fixtures, verified against
    actual hook JSON shapes (session_id/hook_event_name always present;
    SubagentStart/SubagentStop carry agent_id).
    - Add clock seam (_clock/_now()) and replace every time.time() call site.
    - Make save_registry atomic (tmp file + fsync + os.replace) and add
    registry_transaction() (in-process RLock + fcntl.flock) so the bridge's
    own threads and separate CLI invocations can't interleave registry
    writes. Converted every registry-mutating call site to use it.
    - Fix a latent argparse bu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
2026-09-13 Phase 0.3: turn-scoped busy_since, busy_elapsed_ms, session_id guard
    - Add _set_status() so every status write tracks busy_since (set on
    entering a busy status, cleared on leaving one). UserPromptSubmit
    always resets busy_since, even mid-turn (busy -> busy), so the ramp
    measures the current turn.
    - agent_update_event now emits busy_elapsed_ms instead of busy_seconds,
    computed from the underlying float clock (not the truncated int one)
    so millisecond precision survives.
    - _apply_hook_event gains a session_id guard: SessionStart claims a
    slot only if unowned or already owned by the same session; hooks
    from any other session_id are dropped rather than corrupting a slot
    a second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
2026-09-13 Phase 0.4: process-based liveness, drop log tailing entirely
    - Remove script -q teeing, host/logs/, and all pattern-match status
    auto-detection (ANSI_RE, strip_ansi, ACTIVITY_PATTERNS, classify_activity,
    read_log_tail, poll_slot_logs, test_trigger/test-trigger). Hooks are now
    the only status source; terminal_command is just printf-title/cd/export
    SWITCHBOARD_SLOT/exec.
    - Add three-valued Liveness (ALIVE/DEAD/UNKNOWN) via probe_liveness(): a
    --no-open record (no terminal_tty) or a ps failure/timeout is UNKNOWN,
    never auto-freed. A slot is only freed after two consecutive DEAD probes
    (_dead_probe_confirmed/reconcile_liveness) so a transient ps hiccup or a
    freshly-launched tab c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
2026-09-13 Phase 0.5: default working directory (~/Documents) + config subcommand
    - resolve_agent_cwd() implements slot cwd -> defaults.cwd -> ~/Documents
    resolution, always expanduser().resolve()'d. agent_config_for_slot's
    synthesized fallback no longer hardcodes PROJECT_ROOT.
    - launch_agent creates a missing cwd automatically when it's under
    ~/Documents, otherwise fails with exit 2 and points at the new `config`
    subcommand instead of a bare "does not exist".
    - Add `config` subcommand: --slot (with --cwd/--name/--family/--command/
    --effort), --default-cwd, --show. Creates host/agents.json from the
    example if missing, writes with the same tmp+fsync+replace pattern as
    the registry. Takes a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
2026-09-13 Phase 0.6: firmware LED model split out, busy_elapsed_ms + ack, host tests
    - Move all pure LED-rendering logic into led_model.h (no Arduino includes):
    Status enum + statusFromString/statusIsBusy, colorForStatus, the
    white->blue->magenta busyColor ramp (with busyHue/busySaturation exposed
    separately for testing), busyPulsePeriodMs, pulsePeriodFor (needs_input
    fast pulse, unknown slow amber pulse, busy ramp, else solid), and
    renderKey() as the one per-key-per-frame entry point with a 40%-with-floor
    selection dim.
    - The sketch now tracks Status slotStatus[]/slotBusyStartMs[] per key,
    reads busy_elapsed_ms from agent.update (falls back to busy_seconds*1000
    for one release), and a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
2026-09-13 Phase 0.7: end-to-end integration test over a real pty + hook server
    - HOOK_PORT is now overridable via SWITCHBOARD_HOOK_PORT so tests (and a
    second bridge instance) don't have to fight over 8877.
    - Add host/tests/test_bridge_integration.py: a real os.openpty() pair
    stands in for the serial port and a real ThreadingHTTPServer handles
    hooks on an ephemeral port, both driving an actual run_bridge_listener
    thread — only launch_slot_from_config (no real Terminal/AppleScript),
    probe_liveness (controllable stub), and focus_terminal_tab (no-op) are
    faked. Covers: golden launch->turn->stop with exact busy_elapsed_ms,
    no duplicate launch while liveness is UNKNOWN, a DEAD slot freed af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
2026-09-13 Phase 0.8: docs — status colors, hook protocol, test instructions
    - SWITCHBOARD_DESIGN.md: replace the "Agent Status Colors" table with the
    Phase 0 palette actually implemented in led_model.h (soft white
    idle/launched, white->blue->magenta busy ramp, yellow fast pulse
    needs_input, red blocked, green done, amber slow-pulse unknown), note
    the turn-scoped ramp reset and the 40%-floor selection dim, and point at
    firmware/neokey/test/run.sh. Update "Status Auto-Detection Plan" to
    reflect that log-tailing is gone, not "still in place as a secondary
    signal."
    - README_BRIDGE.md: document the board->bridge agent.update.ack and the
    bridge->board agent.update's busy_elapsed_ms shape/s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
2026-09-13 Phase 1.0: sketch name fix — switchboard_neokey.ino -> neokey.ino
    Arduino requires <dir>/<dir>.ino; the mismatched basename made
    `arduino-cli compile firmware/neokey` fail with "main file missing from
    sketch". Rename the file and update every reference (msc_cdc_spike,
    hardware/kicad README, state-and-testing-plan). Historical narrative in
    plug-and-play-installer-plan.md and 4key-business-plan.md keeps the old
    name with a note pointing at the rename.
    Add firmware/neokey/test/compile.sh (compile-only, no upload) alongside
    run.sh; both exit 0. Also commit docs/design/phase1-2-implementation-spec.md,
    the handoff spec this and the following commits implement.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
    [msc_cdc_spike.ino, neokey.ino]
2026-09-13 Phase 1.1: package skeleton + pure modules (model, events, clock)
    Create host/switchboard/ and move the pure, I/O-free pieces of
    switchboard_bridge.py into it:
    - model.py: STATUS_CHOICES, BUSY_STATUSES, effort tables/normalize_effort/
    effort_args/command_with_effort, Liveness, slot_record, set_status
    (renamed from _set_status, now public), agent_update_event, the Claude/
    Codex hook status tables, hook_status_for.
    - events.py: BoardEvent/HookEvent/LivenessObserved/SlotRegistered/Shutdown
    dataclasses, the Event union, and parse_board_line (blank/noise -> None,
    malformed/non-object JSON -> diagnostic str, else BoardEvent).
    - clock.py: Clock protocol, SystemClock, FakeClock — introd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
2026-09-13 Phase 1.2: pure reducer — reduce(slots, state, event, now) -> (slots, effects)
    host/switchboard/reducer.py has no imports of os, subprocess, time, or
    file/network I/O. Every branch of today's describe_event and
    _HookRequestHandler._apply_hook_event becomes a branch here; what used to
    be a printed string is now a Log effect, and every registry mutation is
    now expressed as SendUpdate/Launch/Focus/VoiceKey effects the (not yet
    built) Bridge will apply.
    Carried over exactly: the session_id ownership guard, subagent gating,
    busy_since on enter-busy and every UserPromptSubmit, main_stopped
    clearing, SessionEnd popping the slot. agent.select's liveness handling
    (ALIVE -> Focus+SendUpdate, UNKNOW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
2026-09-13 Phase 1.3: I/O seams — registry, device, liveness, terminal, launcher, hooks
    Move every side-effecting piece of switchboard_bridge.py behind a small
    protocol class, each with one real implementation and one fake:
    - registry.py: Registry(path) — load()/save()/transaction(), the Phase 0
    free functions as methods.
    - device.py: DeviceLink protocol; SerialDevice (the real port, with the
    shared _DEVICE_WRITE_LOCK comment preserved and TIOCEXCL kept),
    FdDevice (pty integration test / --stdin), FileDevice (--sample),
    FakeDevice (records sent, feed()s lines, blocks until close()).
    - liveness.py: ProcessProber (today's probe_liveness, as a class) and
    FakeProber.
    - terminal.py: TerminalD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
2026-09-13 Phase 1.4: Bridge — one queue, one owner
    host/switchboard/bridge.py: Bridge(registry, device, terminal, prober,
    clock, launch_config, auto_launch, dry_run, no_open, log). step() is the
    only code that touches the registry inside the process: resolve liveness
    probes for agent.select/voice.hold.* (the reducer never probes), run
    reduce() inside one registry.transaction(), snapshot the result after the
    lock releases, then apply effects (SendUpdate -> device.send, Launch ->
    build_launch + terminal.open + a re-entrant step(SlotRegistered(...)),
    Focus -> terminal.focus, VoiceKey -> terminal.post_key, Log -> self.log).
    startup_sync() reconciles liveness (confirm=False) via reduce() directly
    (effect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
2026-09-13 Phase 1.5: CLI + shim — switchboard_bridge.py is now a 7-line entry point
    host/switchboard/cli.py: build_parser() uses a shared _add_listen_flags()
    helper attached to both the root parser and the `listen` subparser (so
    `--help` for `listen` lists every flag exactly once) — every other
    subcommand's shared flags (chiefly --registry) keep default=SUPPRESS on
    the subparser so a root-level `--registry PATH` before the subcommand
    isn't silently overwritten by the subparser's own default (the classic
    argparse gotcha). Subcommand functions build real objects directly:
    launch_agent uses launcher.build_launch (folding the old inline
    resolve_command/terminal_command/slot_record sequence into one ca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
2026-09-13 Phase 1.6: golden traces (test_hook_flood_never_resurrects_slot landed in 1.4)
    host/tests/golden/*.in.jsonl (one JSON object per line: {"registry":...}
    to pre-seed, {"t", "board"|"hook"|"liveness"|"startup_sync"} to drive one
    step) + test_golden.py, which replays each trace through a real
    Bridge.step() — FakeDevice/FakeTerminal/FakeProber/FakeClock/Registry(tmp),
    no threads, no sleeps — and compares the exact ordered device.sent list to
    the matching *.out.jsonl. `--update-golden` (registered via conftest.py's
    pytest_addoption) rewrites the .out files for review instead of asserting.
    Eight traces, each pinning one bug from state-and-testing-plan.md §1:
    launch_turn_stop (launched -> idle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
2026-09-13 Phase 1.7: CI — host tests + firmware compile on macos-latest
    .github/workflows/ci.yml: Python 3.14 + host/requirements-dev.txt,
    `pytest host/tests -q -m "not hardware"`, then arduino-cli + the esp32
    core (pinned to 3.3.11, matching `arduino-cli core list` on this Mac) +
    Adafruit seesaw Library/ArduinoJson, caching ~/Library/Arduino15 keyed on
    those versions, then firmware/neokey/test/run.sh (host led_model tests)
    and compile.sh (compile-only, no upload). No test opens a real Terminal
    window or otherwise needs Terminal.app — the two subprocess tests
    (test_registry.py, test_cli.py) only exercise the `status` subcommand,
    and `--dry-run`/`--no-open` cover the rest.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
2026-09-13 Phase 1.8: docs — architecture, adding-a-status checklist, golden traces
    host/README_BRIDGE.md: new "Architecture" section (a diagram of the event
    flow from board/hooks through Bridge.step()/reduce() to effects, plus the
    module table), an "Adding a status" checklist (still multi-file — Phase
    2.5's status_table.py collapses it to one table + one generator command),
    and "Running the tests" now covers golden traces (how to run/review/
    update them with --update-golden) and firmware/neokey/test/compile.sh
    alongside run.sh.
    docs/design/state-and-testing-plan.md §6: Phase 1 marked done
    (3437321..a32436b) with what actually shipped in each bullet.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
2026-09-13 Fix CI: test_bridge_integration.py used a real 'claude' binary that isn't on GitHub's runner
    The pty-harness launch_config had command="claude" (only family should
    have been "claude" — the binary was meant to be a safe stand-in, same as
    test_golden.py's command="cat"). It happened to work locally because this
    Mac has claude installed; on a fresh CI runner resolve_command() raised
    FileNotFoundError inside Bridge.run()'s worker loop, which prints the
    traceback and continues rather than crashing — so every test in the file
    that presses a slot to launch it got zero device lines and timed out.
    Also loosened three timing margins that are fine on this Mac but tight on
    a shared CI runner: test_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
2026-09-13 Bound Bridge.run()'s hook-server shutdown to fix a CI hang
    hook_server.shutdown() blocks until serve_forever()'s loop notices and
    exits; on GitHub's macOS runner this occasionally never returned, leaving
    the run() thread alive well past its `duration` and its `finally` block
    never completing — which then starved the rest of that CI job's threads
    of CPU, cascading into two unrelated pty-integration test failures. Run
    the shutdown in its own thread with a 2s join timeout and always call
    server_close() afterward regardless, so a stuck HTTP server can never
    keep run() from returning.
    Also switched test_worker_survives_step_exception to hook_port=0 (an
    OS-assigned free port) instead of the def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
2026-09-13 Rewrite test_worker_survives_step_exception without threads
    The threaded version (start run() in a background thread, submit events,
    join with a timeout) reproduced identically on GitHub's macOS runner as
    the run() thread never finishing within a 10s join, for a cause I
    couldn't pin down from CI logs alone (the bounded hook-server shutdown in
    the previous commit didn't fix it). It also cascaded into two unrelated
    pty-integration test failures, apparently by starving that runner of a
    CPU core for the rest of the file.
    The invariant under test — run()'s try/except around step() keeps the
    worker alive after one event raises — doesn't actually need a thread or
    run() at all: call bridge.step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
2026-09-13 Diagnose CI-only integration test failures: add reader-thread visibility
    FdDevice.lines() previously swallowed an OSError from os.read() and just
    returned, silently ending the generator with zero indication of why —
    inconsistent with SerialDevice.lines(), which lets a read failure
    propagate to the caller. Removed that inconsistency so a real failure
    reaches read_serial()'s own except OSError and becomes a proper
    Shutdown(error=exc).
    Also logs (via self.log, so it's visible in captured test output) when
    the reader thread's device.lines() loop ends without raising at all, and
    when the worker actually receives and acts on a Shutdown — both were
    previously silent. test_bridge_integration.py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
2026-09-13 Fix CI flake: bridge_harness didn't wait for its background threads to start
    The diagnostic logging added last commit fired on neither path (no
    "device.lines() ended" and no "got Shutdown") on the failing CI run,
    ruling out a silent reader-thread death — the reader thread just hadn't
    reached its read loop yet. The evidence: the same fd number (11) recurred
    across the three failures, and the identical press()-then-expect-launched
    pattern used later in the same file (test_registry_race_no_resurrection)
    passed reliably — only the first couple of `bridge_harness` fixture
    instantiations in a fresh pytest session were affected, consistent with
    one-time thread-scheduling startup cost on a cold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
2026-09-13 Skip 3 CI-flaky pty/thread integration tests on CI only
    test_golden_launch_turn_stop, test_no_duplicate_launch_when_liveness_unknown,
    and test_dead_session_freed_after_two_ticks_and_led_cleared fail
    deterministically on GitHub Actions' macOS runner despite four genuine
    fix attempts (a real hardcoded-"claude"-binary bug plus three hardening
    changes: bounded hook-server shutdown, a de-threaded rewrite of a
    different flaky test, a 0.5s settle delay) — none changed the outcome on
    CI, while all 104 tests pass reliably and repeatedly on this Mac. The
    diagnostic logging added along the way never fired on a failing CI run,
    ruling out a silent reader-thread crash as the cause.
    Per user decision: s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
2026-09-13 Replace the CI skip with a session-level warm-up fixture
    Removing the skip and re-running showed the failure moving to whichever
    three tests ran first once the previous three were skipped — confirming
    it's not those specific tests but a one-time cost paid by the first
    handful of bridge_harness (pty + background thread + socket) uses in a
    fresh pytest process on GitHub's macOS runner. A session-scoped autouse
    fixture now pays that cost once, up front, on throwaway pty/thread/socket
    objects before any real test's assertions start their own clock.
    All six integration tests are back (no more skipping); 104/104 local.
    Claude-Session: htt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
2026-09-13 Try warming up a real ThreadingHTTPServer specifically
    The generic pty+thread+bound-socket warm-up (previous commit) did not
    change the outcome on CI — the exact same three tests failed again. The
    one thing every bridge_harness use does that a bare socket doesn't is
    construct a real http.server.ThreadingHTTPServer via start_hook_server(),
    synchronously, before Bridge.run()'s worker loop starts dequeuing
    anything — if that specifically has a one-time slow path on this runner's
    sandbox, it would stall every submitted event (including a press()'s
    agent.select) until it clears, matching the symptom exactly. Testing
    that theory by constructing and tearing down a real one during warm-up.
    Co-A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
2026-09-14 Phase 2.1: doctor — probe the bridge's operating environment
    `switchboard_bridge.py doctor [--port P] [--registry PATH]
    [--agents-config PATH] [--json]` — host/switchboard/doctor.py. Each check
    probes something real rather than guessing from config: serial port
    (SerialDevice.open(), reporting EBUSY as "another bridge is running
    (LaunchAgent?)"), hook port (a raw socket connect_ex against 8877, cross-
    checked against the LaunchAgent check so "something's listening" and
    "the right thing is listening" are distinguished), Claude/Codex hooks
    installed (via the two install_*_hooks functions' new dry_run=True mode),
    Terminal automation (osascript window count, -1743 = permission denied),
    Access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
2026-09-14 Phase 2.2: done returns to soft white on key press
    Plan §5.1: green (done) holds until the key is pressed or the next
    prompt starts a new turn. Reducer change: agent.select on a slot whose
    status is "done" and whose liveness reads as confirmed (alive) — not
    unknown/unconfirmed — now clears it to "idle" via set_status (which also
    clears busy_since) before the usual Focus+SendUpdate. Threaded `now`
    through _handle_select for this (set_status needs it).
    Firmware unchanged — colorForStatus(Status::Idle) is already soft white.
    Tests: test_select_on_done_clears_to_idle, and a guard
    (test_select_on_done_with_unknown_liveness_does_not_clear) that an
    unconfirmed probe alone must never clear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
2026-09-14 Phase 2.3: unknown-state amber + ack tracking
    Two sources of "the LED may be lying":
    (a) Liveness UNKNOWN. model.agent_update_event gains a keyword-only
    liveness: str | None param — "alive"/"unknown" go into the event's
    "liveness" field, omitted entirely otherwise. reducer.SendUpdate gains a
    matching `liveness` field. ReducerState gains a per-slot unknown_probes
    counter, mirroring dead_probes: two consecutive UNKNOWN liveness
    observations send one SendUpdate flagged liveness="unknown" (not resent
    on every subsequent tick while it stays unknown), and the next confirmed
    ALIVE observation sends one flagged liveness="alive" to clear it. Unlike
    DEAD, UNKNOWN never frees the slot.
    Firmware: re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
2026-09-14 Phase 2.4: ghost-tab cleanup (--close-dead-tabs)
    New `--close-dead-tabs` flag on `listen` (and install_bridge_launch_agent.py,
    default off either way): when the reducer frees a slot via LivenessObserved
    (two consecutive confirmed-DEAD readings) and the record had a
    terminal_tty, it now also emits a CloseTab(tty) effect. Bridge only acts
    on it when close_dead_tabs is set — self.terminal.close(tty), which
    AppleScriptTerminal/NullTerminal/FakeTerminal already implemented back in
    Phase 1.3 in anticipation of this. Terminal's own "close without asking"
    preference governs whether the user is prompted; nothing here forces it.
    Deliberately scoped to the LivenessObserved-driven free only — Sessi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
2026-09-14 Phase 2.5: shared status table generating the firmware header
    host/switchboard/status_table.py's STATUSES tuple is now the single
    source of truth for the status vocabulary: busy-ness, which hooks (per
    CLI family) produce each status, and the LED color/pulse. STATUS_CHOICES,
    BUSY_STATUSES, CLAUDE_HOOK_STATUS, CODEX_HOOK_STATUS, and CODEX_HOOK_EVENTS
    are all derived from it; model.py and hooks_install.py just re-export
    them so every existing call site is unchanged. hooks_install.py's
    CLAUDE_HOOK_EVENTS (the per-hook matcher table, e.g. PreToolUse only for
    AskUserQuestion) is now status_table.HOOK_MATCHERS.
    `python3 -m switchboard.status_table --emit-header` generates
    firmware/neokey/status_ta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
2026-09-14 Phase 2.6: docs — liveness field, doctor, --close-dead-tabs, ack retry
    SWITCHBOARD_DESIGN.md's "Agent Status Colors": notes the table is now
    generated from status_table.py (not hand-maintained), adds a "The
    liveness field" subsection explaining agent.update's optional
    alive/unknown field, how it overrides whatever `status` would otherwise
    render, and where the logic lives on both sides (ReducerState.unknown_probes
    / neokey.ino's slotUncertain[]). "Done" row notes it now clears on
    press/next-prompt rather than holding indefinitely.
    host/README_BRIDGE.md: new "Doctor" section; --close-dead-tabs documented
    under both "Run with the board" and "Install as a login background
    bridge" (install_br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
2026-09-14 liveness: log why a probe returned UNKNOWN, bump ps timeout 2.0s -> 3.0s
    Confirmed live: a real, healthy Claude session (with several MCP server
    child processes on its tty — playwright, an alpaca MCP server, a uv-
    managed python, node) flipped to two consecutive UNKNOWN liveness reads
    right after finishing a turn, pulsing the new Phase 2.3 amber for a few
    seconds before recovering on its own. Re-running the exact `ps -o comm=
    -t <tty>` probe against that same tty afterward returned cleanly (exit 0,
    every child process listed) — so this wasn't a persistent misdetection,
    but there was no way to tell *why* the probe came back UNKNOWN in the
    moment, since ProcessProber silently swallowed the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
2026-09-14 Fix: bridge log lines could sit unflushed indefinitely under the LaunchAgent
    Confirmed live: the new liveness-probe diagnostic line from the previous
    commit never appeared in bridge.out.log minutes after an amber event, and
    zero other log lines had been appended since a fresh restart despite
    the process running the whole time. Cause: `listen` runs indefinitely
    with stdout redirected to a plain file (not a tty) under the LaunchAgent,
    which CPython fully block-buffers by default — every bare `print(message)`
    call (Bridge's default `log`, and cli.py's `ProcessProber(log=print)`)
    could sit in memory for arbitrarily long instead of reaching disk.
    Bridge's default log is now `_default_log`, whi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
2026-09-14 Log the raw Notification message (diagnostic only, no behavior change yet)
    Confirmed live: a Claude Code session sitting idle with a suggested next
    prompt (auto mode, no actual permission dialog) fired a Notification hook
    that got mapped straight to needs_input — a real instance of the gap
    SWITCHBOARD_DESIGN.md already documents as unimplemented ("Notification-
    text matching"): every Notification currently maps to needs_input
    regardless of what it actually says, but Claude Code fires that hook for
    more than "needs your permission" alone.
    Rather than guess at a message-matching heuristic without real data
    (risking suppressing a genuine permission-needed state), _reduce_hook_event
    now emits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
2026-09-14 Recovery 3: make neokey.ino fail loudly
    The seesaw hosts the LEDs, so a hung seesaw and wrong firmware both look
    identical from outside: dark keys, no output. Add boot/error JSON lines
    (start, retry, ready) so the bridge and a human with a serial monitor can
    tell what's actually happening, without touching key mapping, LED
    rendering, the JSON protocol shape, or the seesaw no-reset workaround.
    Host reducer logs boot/error lines without mutating slot state.
    See docs/design/wrong-firmware-recovery-plan.md Phase 3.
    [neokey.ino]
2026-09-14 Recovery 4: make the spike unmistakable
    msc_cdc_spike now emits a JSON-shaped, self-identifying boot/ping line
    (firmware=msc_cdc_spike) instead of plain log text, and sets
    productRevision("spike") so system_profiler shows it too.
    Host: doctor gains check_firmware_identity — FAILs if /Volumes/SWITCHBD
    is mounted or the first boot line isn't firmware=neokey, WARNs if no
    boot line arrives in time (boot lines are power-up-only, so a board
    already running is expected to be silent), OKs with the build string
    otherwise. The bridge reducer now logs loudly (without crashing or
    exiting) whenever it sees a boot line from anything other than neokey.
    SWITCHBD volume label is untouched, per the plan's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
    [msc_cdc_spike.ino]
2026-09-14 Add wrong-firmware recovery + silent-failure hardening plan
    Handoff doc for the NeoKey board incident: seesaw-hang and wrong-
    firmware (msc_cdc_spike left flashed after the plug-and-play spike)
    looked identical from outside. Phases 3-4 (this repo's code changes)
    are implemented in the following two commits.
2026-09-14 Add auto-install plan: one-click installer, cross-platform bridge, PTT fix
    Handoff plan for the plug-in-and-install experience: composite CDC+MSC
    firmware, thin on-device stubs, uv-bootstrapped transactional installer
    with launchd/schtasks adapters, and platform seams for a Windows port.
    Also documents the push-to-talk root cause (synthetic keyDown never
    autorepeats, so each hold reaches the terminal as a single tap), the
    KeyInjector fix, /voice enablement strategy, and the permissions
    onboarding step. Owner decisions recorded inline.
    Claude-Session: https://claude.ai/code/session_01YRqc5wshgXhemCsE1DfXik
2026-09-14 Fix: idle "waiting for your input" Notification flipped done slots to needs_input
    Claude Code's Notification hook fires for several notification_types;
    only permission_prompt/elicitation_dialog mean the user is actually
    blocking Claude. The idle_prompt nudge (~60s after a turn) was mapped to
    needs_input too, so a green "done" key turned yellow a minute later.
    NEEDS_INPUT_NOTIFICATION_TYPES in status_table.py now drives both the
    hook matcher (so other types never leave Claude Code) and a reducer
    guard (for installs whose hooks predate the matcher). Payloads with no
    notification_type keep the old behaviour. `doctor` reports existing
    registrations as "stale marker" until install-hooks is re-ru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
2026-09-15 Add slot settings UI + CLI-family parity plan
    FamilyRegistry (one profile per CLI with detection, effort flags, hook
    spec, and an honest support tier), a v2 settings model with a loopback
    web UI and CLI sharing one service, a VoiceProvider abstraction so
    push-to-talk works for Codex/Gemini/Kimi via a system dictation app's
    hotkey, and a Codex parity phase driven by a verified capability
    matrix. Owner decisions recorded inline.
    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
2026-09-15 Slots 0.1: family capability matrix (Claude/Codex/Gemini/Kimi)
    Phase 0 of the slot-settings-and-family-parity plan: read each CLI's
    --help and bundled docs (Gemini CLI installed to a scratch npm prefix,
    Kimi Code CLI's docs read from moonshotai.github.io), plus this
    machine's real Codex/Claude config, to record hooks/effort/voice/env
    support per family and the merge-strategy gap Kimi's TOML hooks create.
    No live 10-minute session was run for Gemini or Kimi (neither installed
    for real use) — flagged under "Not yet verified" per the plan's rule
    that unconfirmed capabilities default to unsupported.
    Claude-Session: https://claude.ai/code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
2026-09-15 Slots 1.1: FamilyRegistry refactor, no behaviour change
    Phase 1 of the slot-settings-and-family-parity plan. New
    host/switchboard/families/{base,claude,codex,generic,__init__}.py: one
    FamilyProfile per CLI (executables, known_paths, detect(), effort_args(),
    hook_spec(), capabilities()/tier), a GenericProfile that satisfies the
    same protocol with every capability False, and a FamilyRegistry that
    looks a profile up by name or infers one from a command's basename.
    model.py's effort_args()/hook_status_for() and launcher.py's
    KNOWN_COMMAND_PATHS now ask the registry instead of branching on
    `family == "claude"`/`"codex"` literals; hooks_install.py collapses to
    two small generic installers (_insta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
2026-09-15 Slots 2.1: settings v2 schema, SlotSettingsService, bridge hot reload
    Phase 2 of the slot-settings-and-family-parity plan.
    New host/switchboard/settings.py: the v2 on-disk schema
    (settings_version: 2, "slots" instead of v1's "agents", "args" separate
    from "command", optional "voice"/"env"), a stdlib validate_document()
    (no jsonschema dependency) returning FieldError(path, message, severity)
    with "warning"-severity findings (command not resolvable) that don't
    block a save vs "error"-severity ones that do (bad slot number, unknown
    effort/voice provider, a cwd missing outside ~/Documents), the v1->v2
    migration (agents -> slots, title dropped — regenerated same as before),
    and SlotSettingsSer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
2026-09-15 Slots 2.2: fix agent slot count to 3 (key 4 is push-to-talk, not a slot)
    Correction to Phase 2: firmware/neokey/neokey.ino defines
    AGENT_SLOTS = {1, 2, 3} and a separate PTT_KEY_INDEX (the 4th physical
    key) that drives voice.hold.start/stop for whichever agent slot is
    currently selected — it was never a 4th agent slot. Phase 2 had wrongly
    copied the plan doc's "1-4" range from README_BRIDGE.md's own inaccurate
    "four stable agent slots" line instead of checking the firmware.
    - settings.py: MAX_SLOT 4 -> 3; migrate_v1_to_v2 now drops a legacy
    out-of-range slot (this machine's real agents.json has a dead "slot 4"
    entry from before this was caught) instead of carrying it into v2,
    where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
2026-09-15 Slots 3.1: settings web UI (loopback, no dependencies)
    Phase 3 of the slot-settings-and-family-parity plan.
    New host/switchboard/ui/{__init__,api}.py: pure request/response building
    for the settings page's JSON API (settings_get/settings_put with
    optimistic concurrency + field-error responses, families_get, status_get,
    voice_providers_get — the latter honestly reports "hotkey" as
    unavailable since Phase 4's VoiceProvider abstraction doesn't exist yet)
    and {index.html,app.js,styles.css}: a hand-written, dependency-free,
    phone-width-friendly page with one card per real agent slot (1-3 — key 4
    is push-to-talk, called out explicitly in the page's own footer text) —
    CLI dropdown from /api/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
2026-09-18 Slots 4.1: VoiceProvider abstraction (family-agnostic PTT)
    Phase 4 of the slot-settings-and-family-parity plan.
    New host/switchboard/voice/{base,claude_native,hotkey,none,builtin_stt,
    __init__}.py: a VoiceProvider protocol (available()/hold(ctx)/release(ctx))
    and a VoiceRegistry the same shape as families.FamilyRegistry.
    - claude_native: today's verified behaviour (hold Space via the
    repeating KeyInjector), unchanged in effect — just moved out of
    bridge.py's SPACE_KEYCODE constant into its own module.
    - hotkey: the plan's recommended family-agnostic answer (focus + drive a
    system dictation app's shortcut). Implements hold/toggle mode
    correctly (toggle taps the chord twice — onc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
2026-09-18 Slots 5.1: Codex parity — real hooks, real effort tiers, slash_commands()
    Phase 5 of the slot-settings-and-family-parity plan.
    5.1 Status: extracted Codex's own embedded hook-event JSON schema via
    `strings` on the installed binary — it actually knows 12 events
    (PreToolUse, PermissionRequest, PostToolUse, PreCompact, PostCompact,
    SessionStart, SessionEnd, UserPromptSubmit, SubagentStart, SubagentStop,
    Stop, Interrupt), more than Phase 0 assumed. Ran a real `codex exec`
    session against a temporary hooks.json wired to a throwaway local
    logger, covering all 12, to see which actually fire — confirmed
    UserPromptSubmit/PostToolUse/Stop/SessionEnd fire with real payload
    shapes (recorded in fa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
2026-09-18 Slots 3.2: restyle the settings UI
    Visual redesign of the Phase 3 settings page — no behavior/API changes,
    same stdlib-served, dependency-free page.
    - Header gets a small 4-key wordmark (inline SVG, colored to match each
    slot's accent) and a dot-status pill.
    - Each slot card gets a colored left-border accent (one hue per key), a
    keycap badge, the name as an inline-editable title, and a real 2-column
    field grid that collapses to 1 column under 460px.
    - Status pill now colors by the actual status word instead of just
    ok/muted — the mapping mirrors status_table.py's own LED colors (busy
    states blue, needs_input/waiting amber, blocked red, done green,
    unknown orange) so the page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
2026-09-18 Add LED pulse settings: idle breathing + thinking cycle speed
    A new UI area, built full-stack (firmware -> wire protocol -> host ->
    web UI) after a design discussion: two board-wide presets, editable
    from the settings page, that reshape the board's LED feel without a
    firmware rebuild for a settings change (only the feature itself needs
    one, once).
    firmware/neokey/led_model.h: turned two previously-hardcoded constants
    into optional parameters (default = today's exact behavior, so every
    existing call site and test is unaffected) — busyRampMs threads through
    busyRampProgress/busyHue/busySaturation/busyValue/busyColor/
    busyPulsePeriodMs (how long the busy color ramp takes, which also scales
    h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
2026-09-20 Add diagnostic trace writer and design spec (stage 1/7)
    TraceWriter appends redacted, size-bounded JSON-lines records for
    debugging Switchboard bridge issues on user machines. Nothing wires
    into the bridge yet — this is the pure, tested primitive per
    docs/design/diagnostic-trace-and-support-bundle-spec.md section 4.
2026-09-20 Wire the diagnostic trace into the Bridge's event loop (stage 2/7)
    step() now diffs every slot's status before/after each reduce() call
    and emits transition/freed/hook/board/liveness/registered/effect/ack
    records to trace.jsonl, plus a 60s heartbeat with per-slot dwell time.
    bridge.out.log gains a timestamp prefix so elapsed time is finally
    measurable from the human log alone. model.set_status/slot_record
    gain status_since, the field dwell_ms is computed from.
    Everything defaults to NullTraceWriter (spec section 5.1) so no
    existing caller or test changes behavior without opting in.
2026-09-20 Add liveness probe evidence and hook-receipt tracing (stage 3/7)
    ProcessProber.probe now records the ps comm list (or the reason a
    probe couldn't run) to the trace on every DEAD/UNKNOWN result, so a
    slot that frees or goes amber can be checked against real evidence
    instead of guessed at.
    hooks_server records each hook's receipt time and redacted metadata
    before queueing it, separately from Bridge.step's processing record —
    the installed hook command is `curl --max-time 1 || true`, so a slow
    bridge silently drops hooks; a hook_rx with no matching `hook` shortly
    after is that fingerprint. HookEvent gains rx_mono for this.
    _make_bridge wires a real trace (via switchboard.trace.open_default)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
2026-09-20 Suppress listen's repeat log spam and rotate bridge.out.log (stage 4/7)
    _Repeater collapses "No USB serial port found", "Could not open ...
    Retrying", and (fixed after a smoke test caught it live) "Listening
    on ..." down from one line per retry-delay tick to first-occurrence
    plus an occasional marker. One week of mostly-idle capture on a real
    machine was 179,386 of 179,734 lines of exactly this spam.
    listen() now shares one TraceWriter across --sample/--stdin/serial
    paths, gated by the new --trace-verbose flag (or
    SWITCHBOARD_TRACE_VERBOSE=1) for full hook payloads, and writes
    `serial` trace records on connect/lost/searching transitions.
    bridge.out.log gets a sudo-free startup-only rotation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
2026-09-20 Add switchboard support-bundle: one zip for off-machine diagnosis (stage 5/7)
    build_bundle() zips trace.jsonl (concatenated oldest-to-newest across
    rotated backups, --since filterable), a tail of bridge.out.log/.err,
    doctor's checks, agents.json/agent_registry.json, versions.txt
    (switchboard git SHA, python, macOS, claude/codex --version), the
    LaunchAgent plist, and only the Switchboard-marked hook groups from
    ~/.claude/settings.json and $CODEX_HOME/hooks.json (reusing
    hooks_install's own marker logic, never the whole file).
    Every source is best-effort: a missing file becomes a `<name>.missing`
    member instead of failing the bundle, since this is exactly what a
    user runs when the bridge isn'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
2026-09-20 Add "Download diagnostics" button to the settings UI (stage 6/7)
    GET /api/support-bundle streams the same zip as `switchboard
    support-bundle` on the CLI, gated by the same X-Switchboard-Token the
    settings PUT already requires — a page in another tab can't pull it.
    api.support_bundle_get() builds into a temp file and reads it back so
    hooks_server can stream it with Content-Disposition: attachment.
    The settings page gets a new Support card with one button; app.js
    fetches with the token header (a bare <a href> can't carry it),
    turns the response into a Blob, and triggers a download via a
    temporary <a download> element.
    Verified live end-to-end: served page contains the button, the route
    403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
2026-09-20 Document trace.jsonl and support-bundle in README_BRIDGE.md (stage 7/7)
    New "Diagnostics" section: where trace.jsonl lives, its redaction
    promise, --trace-verbose, size bounds, and how to pull a support
    bundle from the CLI or the settings page's new button.
    This completes docs/design/diagnostic-trace-and-support-bundle-spec.md.
2026-09-20 Fix CI hang: bound doctor's Terminal-automation check with a timeout
    check_terminal_automation()'s `tell application "Terminal"` launches
    Terminal.app if it isn't running, which hangs indefinitely on a
    headless/CI runner instead of failing fast — confirmed live: this
    call, unbounded, stalled the GitHub Actions macOS runner for the
    entire "Run host tests" step once test_support_bundle.py and
    test_ui_api.py started calling build_bundle()/doctor.run_checks() for
    real (stages 5-6 of the diagnostic-trace work). Times out at 5s and
    reports a warn instead.
2026-09-21 Fix: a stray Codex session's SessionEnd could free an actively-working slot
    Confirmed live via a support-bundle trace: slot 2 (codex) was picked
    up correctly by session A's first UserPromptSubmit, then a second,
    unrelated Codex process also tagged SWITCHBOARD_SLOT=2 sent
    SessionEnd — freeing the slot out from under session A 44s into
    "working" and losing tracking of it (the "released the active cli
    from monitoring" report).
    Root cause: the reducer's session-ownership guard only ever claimed a
    slot's session_id on a SessionStart hook. Codex never sends
    SessionStart (see families/codex.py's docstring — its event list is
    UserPromptSubmit/PermissionRequest/PostToolUse/Stop/SessionEnd only),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
2026-10-03 Give idle's LED breathing a much lower dim floor than other pulsing statuses
    A "giant breath" on idle reads better close to fully off at its lowest
    point, unlike needs_input's blink or the busy pulse which need to stay
    visible. Also ignore host/agents.json.bak.
2026-10-03 Make setup.sh actually verify the install it just did
    setup.sh claimed idempotency but never checked its own work. It now runs
    doctor as a final gate and dies with a clear message on any real [fail]
    (a board not being plugged in yet was already [warn], so this is safe to
    run unconditionally). Also fixes a race the new gate surfaced: doctor run
    immediately after restarting the LaunchAgent could catch the bridge
    mid-startup and print a spurious "hook port: nothing listening" on an
    install that was actually fine - fixed with a bounded poll instead of a
    blind sleep.
    Smoke-tested live on this machine (already fully set up): two
    re-runs both correctly skipped existing state and passed the new
    doc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
2026-10-03 Fix bridge.err.log never rotating and bridge.out.log only rotating at startup
    Two real bugs: bridge.err.log was never rotated at all (only
    bridge.out.log was), and that rotation only ran once at process start -
    useless for a LaunchAgent (KeepAlive: True) meant to stay up for weeks,
    since renaming the path mid-run doesn't stop the *current* process's
    writes from landing in the renamed, still-open inode.
    Fixed by having the bridge stop relying on launchd's raw stdout/stderr
    fd inheritance: RotatingStream (switchboard/trace.py) reassigns
    sys.stdout/sys.stderr to instances backed by the same
    RotatingFileHandler mechanism trace.jsonl already used, active only
    under the LaunchAgent (SWITCHBOARD_M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
2026-10-03 Add double-clickable Settings and Update apps
    No terminal required for either going forward. Both are plain macOS
    .app bundles built via osacompile (no new dependency, no signing) -
    switchboard/osa_app.py is the shared helper: wraps one shell command
    with try/on-error AppleScript so a failure surfaces as a native
    notification using the command's own stderr, instead of silently doing
    nothing.
    install_settings_app.py -> ~/Applications/Switchboard Settings.app wraps
    the existing `switchboard settings` command verbatim.
    install_update_app.py -> ~/Applications/Switchboard Update.app runs
    `git pull --ff-only && setup.sh` - intentionally the simplest thing that
    works for this project's macOS-only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
2026-10-04 Fix real generator bugs found by an independent pre-fab hardware review
    Verified all 41 ESP32-S3-WROOM-1 pins and all 24 XL9555 pins in
    boarddef.py against their primary-source datasheets (not search-engine
    summaries, which were caught being wrong twice: once claiming XL9555's
    SDA/SCL were swapped, once claiming two WROOM-1 GND/thermal pins were
    GPIOs). Both parts' full pin assignments match exactly.
    An independent Opus review of the whole design caught three real issues
    a pinout check alone couldn't:
    - gen_pcb.py ignored a part's `nc` (no-connect) list entirely, while
    gen_sch.py respected it - real schematic/PCB drift for any pin that
    has both a plausible net name and an explicit no-c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
    [12key.kicad_pcb, 12key.kicad_sch, 4key.kicad_pcb, 4key.kicad_sch, 8key.kicad_pcb, 8key.kicad_sch]
2026-10-04 Merge the plug-and-play installer spike into the real NeoKey firmware
    firmware/msc_cdc_spike validated composite CDC+MSC on real hardware
    (2026-09-12) but lived standalone with no NeoKey code at all. This
    merges that code directly into firmware/neokey/neokey.ino: the board
    now enumerates a small read-only "SWITCHBD" drive carrying a
    double-clickable installer stub alongside its normal serial protocol,
    so handing a board to someone else (e.g. a friend on a fresh Mac) is
    close to actual plug-and-play instead of "open a terminal and paste
    two commands."
    USB.begin() now runs immediately in setup(), before the NeoKey/seesaw
    init, so the installer drive appears even if that chip is misbehaving.
    R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
2026-10-04 Fix 4key I2C pull-up placement, grow the board, finish routing
    Root-caused the 4key board's unrouted/short-prone corner: R4/R5 (the
    I2C pull-ups for U2) were placed 16mm from the chip they serve, forcing
    their traces across every other bus lane on the board. Moved them next
    to U2 in boarddef.py, and grew STRIP 46mm -> 58mm (87.2x70.5mm ->
    87.2x82.65mm) to give that whole corner real room — both the autorouter
    and hand-routing had been failing to close the last nets in the old,
    cramped layout.
    route_strip()'s I2C section also hard-shorted SCL/SDA into +3V3 and
    into each other once U2 moved down next to R4/R5 (caught by an
    independent Opus review before fab) — rewritten to route both nets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
    [12key.kicad_pcb, 12key.kicad_sch, 4key.kicad_pcb, 4key.kicad_sch, 4key_case_plate.stl, 4key_case_tray.stl, 8key.kicad_pcb, 8key.kicad_sch]
2026-10-04 Wire up Antigravity's lifecycle hooks
    Antigravity's hooks.json is project-local (lives in a slot's own cwd,
    under .agents/), not a single global config file the way Claude/Codex's
    are — so this adds a new HookSpec.merge_strategy, "merge_named_hook",
    that writes/merges just the "switchboard" key in that file, and calls
    it from launcher.build_launch() on every launch (the only sensible
    install point, since there's no global "install once" equivalent for
    this family).
    Installs 4 of the 5 real events (PreToolUse, PostToolUse, PreInvocation,
    Stop — PostInvocation is left out, it never maps to a tracked state
    transition). PreToolUse is matcher-restricted to the "ask_question" tool
    (confirmed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
2026-10-10 Add custom app icons for Settings and Update apps
    Wires Codex-generated gear/arrow artwork into the real .app bundles:
    compile_app() now accepts an icon_path and overwrites osacompile's
    default applet.icns. gen_icns.py builds the two .icns files from raw
    source art, re-centering content first so macOS's automatic icon mask
    doesn't clip it.
2026-10-10 Ignore Antigravity's generated .agents/hooks.json
    Written per-checkout by hooks_install.py's merge_named_hook installer
    on first antigravity-family launch — generated/local state, same as
    agents.json.
2026-10-10 Route the 12key board's remaining nets via FreeRouting
    4key's own strip/LED-chain routing was already proven for every tier;
    the genuinely new problem was the 3-row key-to-expander fan-in onto
    U2's one tight pin column, and the 0.65mm-pitch I2C/HDR cluster right
    next to it. Two hand-rolled routing passes (channel-routed key matrix,
    pad-lookup-based strip extras) each found and fixed real bugs but kept
    surfacing new ones in the same corner - a genuine congestion problem,
    not a coordinate mistake, confirmed by checking candidate paths against
    the board's actual copper (including the key switches' own big center
    mounting-hole pads) before placing anything.
    Fixed properly instead:
    - boarddef.ro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
    [12key.kicad_pcb]
2026-10-11 Fix false-positive wrong-firmware check after the installer merge
    check_firmware_identity() still treated a mounted /Volumes/SWITCHBD as
    proof of msc_cdc_spike firmware, predating the plug-and-play installer
    merge (04a21b1) that gave the real neokey firmware its own SWITCHBD
    installer drive too. That made every correctly-flashed board fail
    `setup.sh`'s verification step — confirmed live on a laptop running
    the real firmware. Now relies only on the serial boot event's
    firmware field, which was already read correctly as the fallback.
2026-10-15 4key r2: move hot-swap pads to B.Cu and fix r1's GND/3V3 opens
    r1 put the Kailh socket pads on F.Cu, the side the switch plugs into, so
    no key could connect. Socket pads now on B.Cu (footprint, generator and
    4key board), with a via at each routed pad 1 to reach the F.Cu KEY trace.
    DRC on r1's as-fabricated fills also showed the GND pour split into 8
    islands (LDO, expander, CC pull-downs and ESD diode all cut off from USB
    ground) and the I2C/INT pull-ups plus J2 pin 1 off +3V3. Added stitching
    vias, routed the missing +3V3 links (J2 via FreeRouting), and cleared the
    LEDCH0 / SW_RST and USB_DP / J1 clearance violations. 4key is now DRC
    clean with 0 unconnected items.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
2026-10-15 12key r2: re-route the KEY nets cut by the socket-pad move; fix GND islands
    Moving the hot-swap pads to B.Cu ripped up KEY5/6/9/10/11, which ran
    through the new pad sites. Re-routed them with FreeRouting against locked
    existing wiring. Also stitched the GND pour islands (LDO, CC pull-downs,
    ESD diode, J1 A1/B12 were cut off from the main ground) and moved LEDCH0
    clear of the SW_RST pads. 12key is now DRC clean with 0 unconnected items.
2026-10-15 8key r2 (WIP): move hot-swap socket pads to B.Cu
    Socket pads moved to B.Cu like 4key/12key. KEY nets were never routed on
    this tier and are still unrouted - not ready to fab. README now points at
    the r1 originals in git history instead of local backup folders.
